spa-pal/UKU207_DOCS/src/фото/207_14/PXL_20231024_051923921.jpg

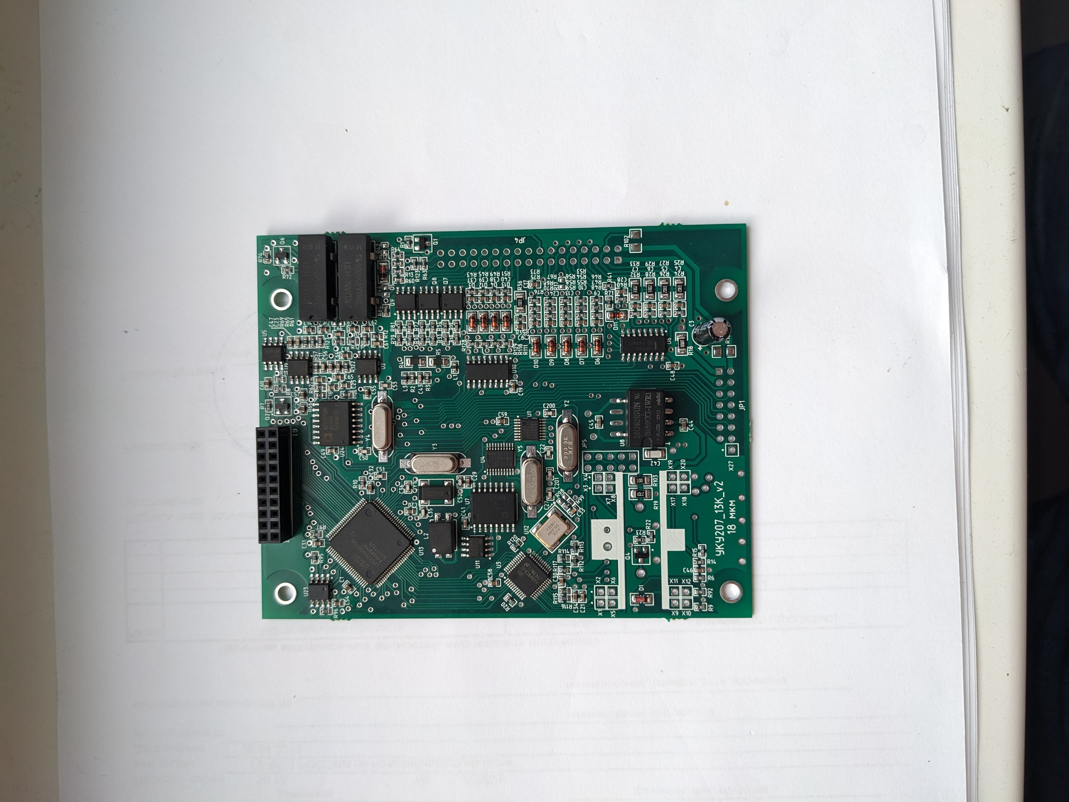
src/фото/207_14/PXL_20231024_051923921.jpg
