spa-pal/UKU207_DOCS/Названия вариантов пайки SMD.docx

Плата контроллера

| Ethernet | Измеритель токов батарей | ФЗ | Применение
УКУ207_13К_v2_SMD1 (УКУ207.14) | + | + | - | 14.48
УКУ207_13К_v2_SMD2 (УКУ207.12/13) | + | - | + | 11.70, 11.220, 12.48, 12.220, 13.70, 13.220,
УКУ207_13К_v2_SMD3 | - | + | - | 16, 16R

Плата источника питания

| Uin | LBH10 | RS485 | Применение
УКУ20713_power_SMD1 | 220 | + | 1 | 11.220,
УКУ20713_power_SMD2 | 220 | + | 2 | 13.220,
УКУ20713_power_SMD3 | 48 | - | 1 | 14.48, 12.48
УКУ207_13К_v2_SMD3 | - | + | - | 16, 16R
