spa-pal/UKU207_DOCS/УКУ207.11.24-70.docx

Инструкция по сборке УКУ207.11.24-70

Исходные материалы:

Плата индикации - УКУ207_14И_SMD

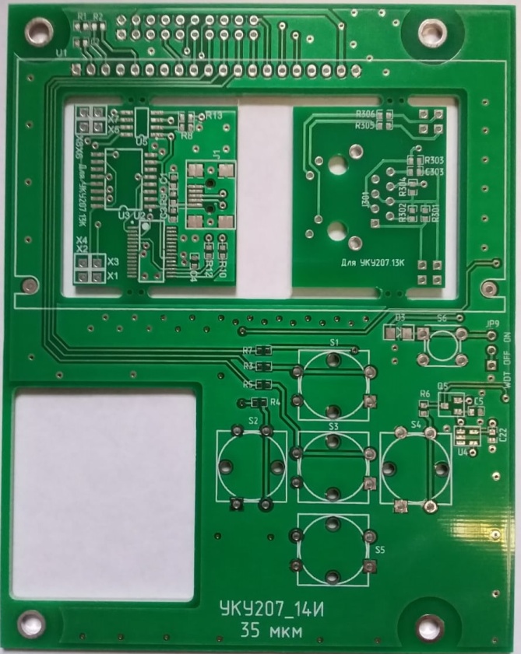
[picture p3: figure]

Плата контроллера - УКУ207_13К_v2_SMD2

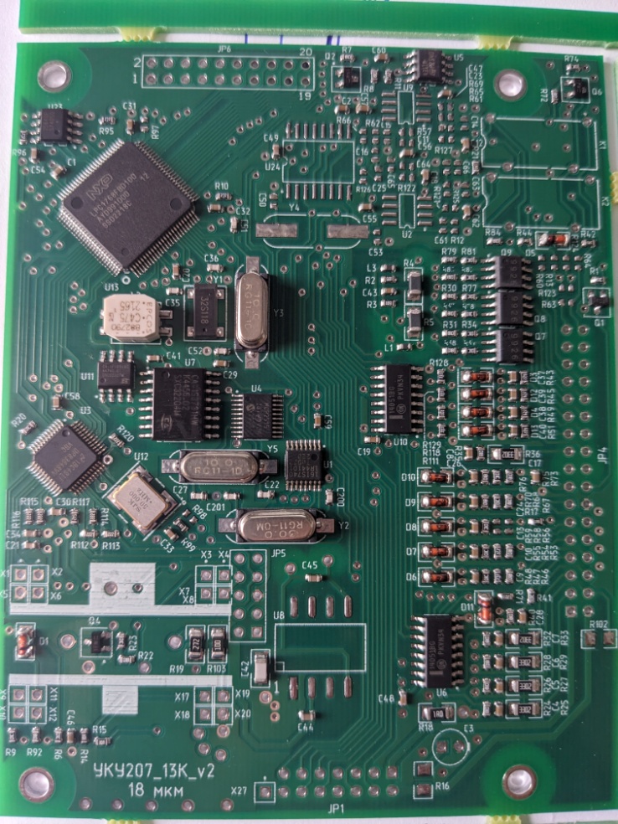
[picture p4: figure]

Плата источника питания - УКУ20713_power_SMD1

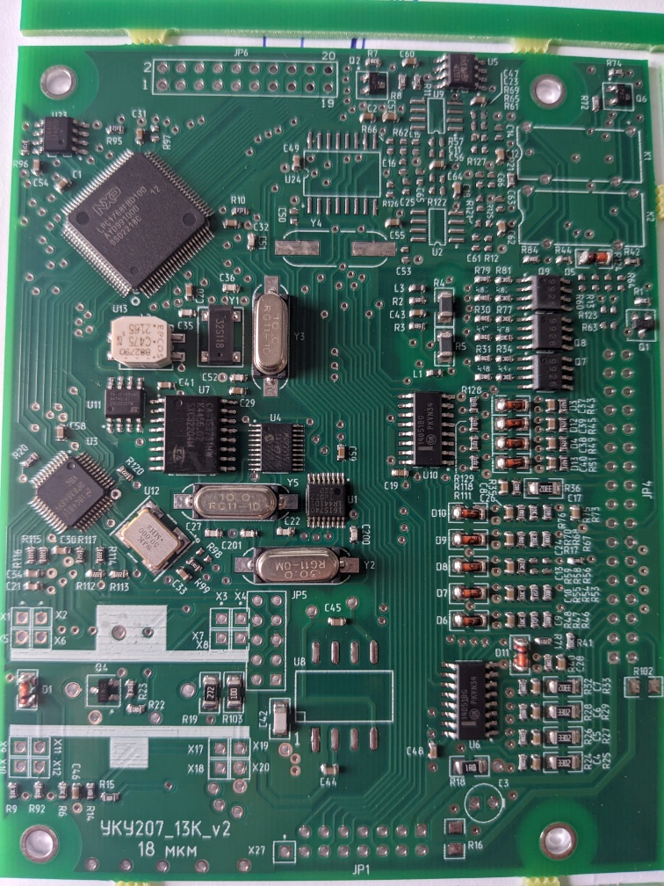
[picture p5: figure]

Плата переходник 34-14

Список элементов на допайку – УКУ207.11.24-70 список выводных элементов
