spa-pal/UKU207_DOCS/src/фото/207_12/PXL_20231101_090011275.jpg

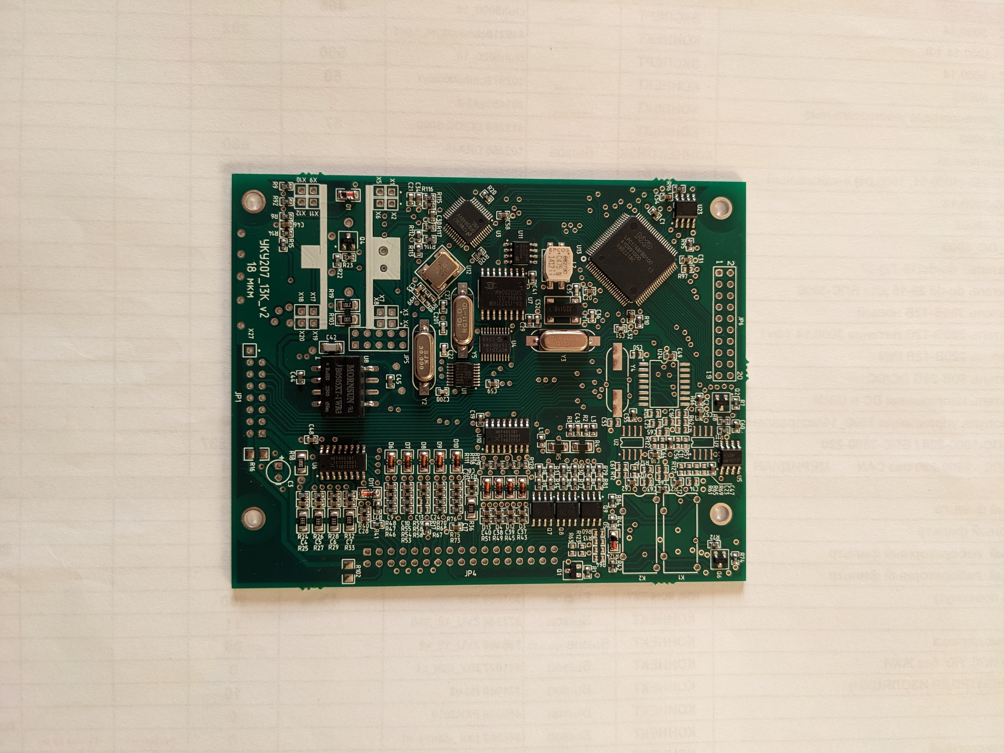
src/фото/207_12/PXL_20231101_090011275.jpg
