spa-pal/UKU207_DOCS/src/фото/207_12/PXL_20231101_101607342.PORTRAIT.ORIGINAL.jpg

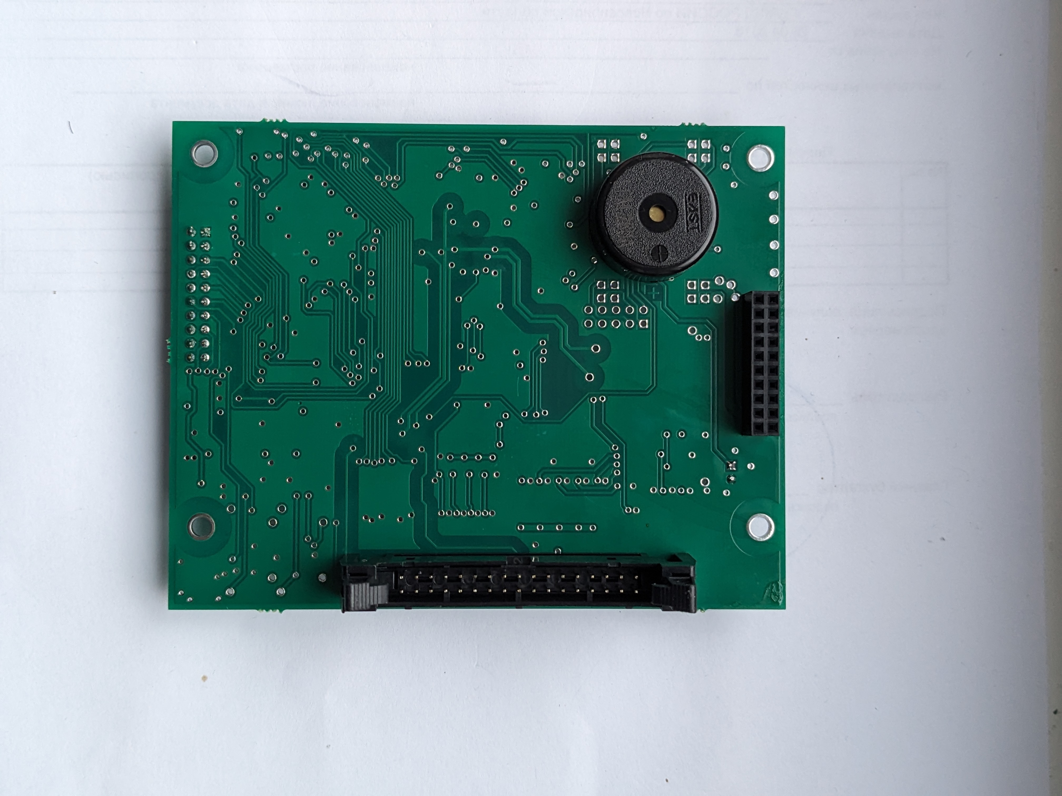
src/фото/207_12/PXL_20231101_101607342.PORTRAIT.ORIGINAL.jpg
