spa-pal/UKU207_DOCS/src/фото/207_14/PXL_20231024_045429906.jpg

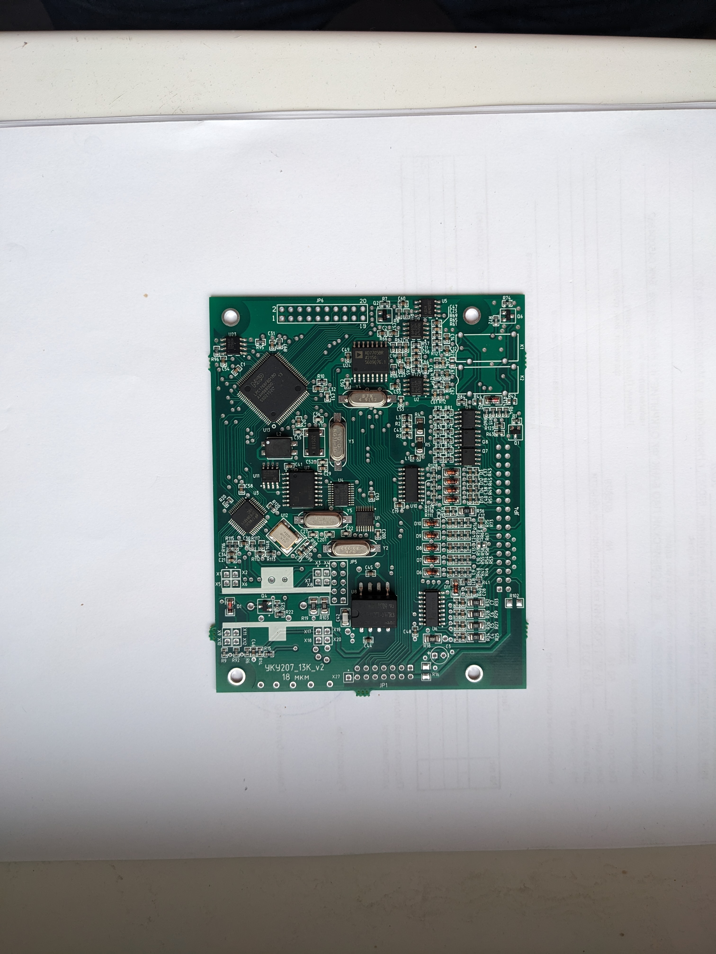
src/фото/207_14/PXL_20231024_045429906.jpg
