spa-pal/UKU207_DOCS/src/фото/207_14/PXL_20231024_105109029.jpg

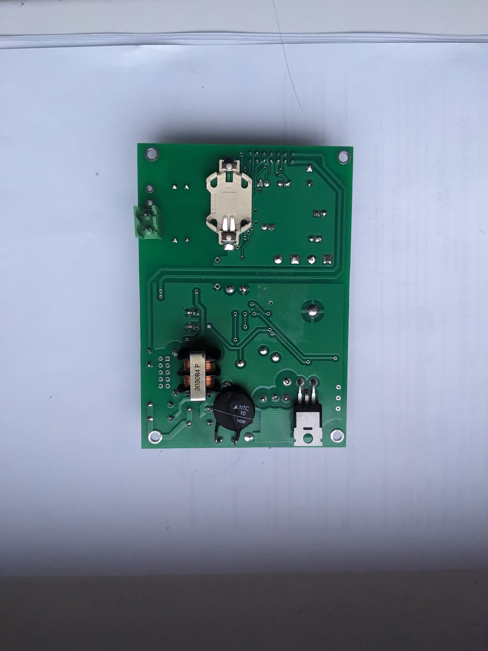
src/фото/207_14/PXL_20231024_105109029.jpg
