spa-pal/UKU207_DOCS/src/фото/ИП220/PXL_20231101_123538262.jpg

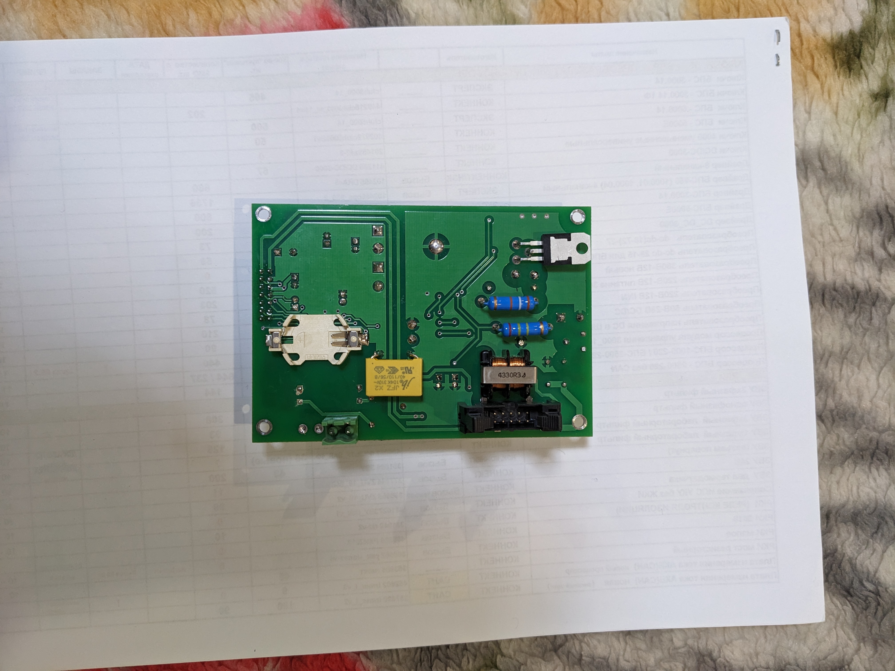
src/фото/ИП220/PXL_20231101_123538262.jpg
