spa-pal/UKU207_DOCS/src/фото/ИП220/PXL_20231101_123554550.jpg

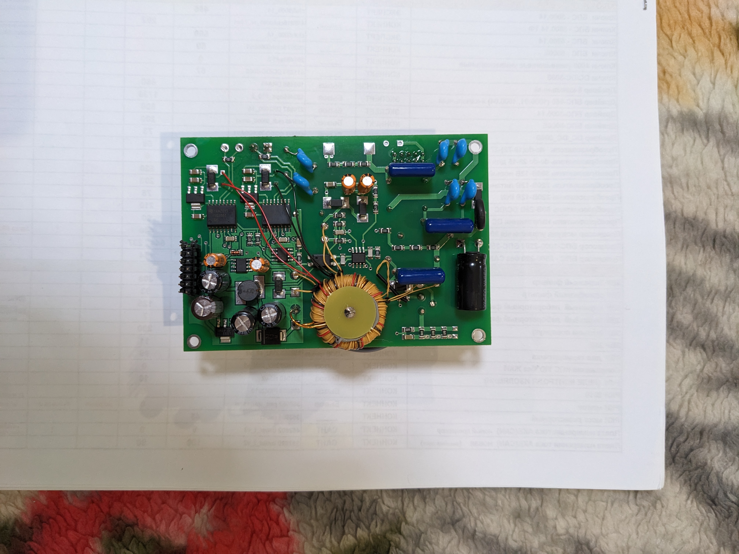
src/фото/ИП220/PXL_20231101_123554550.jpg
