spa-pal/UKU207_DOCS/src/фото/УКУ207_13И_безSMD.jpg

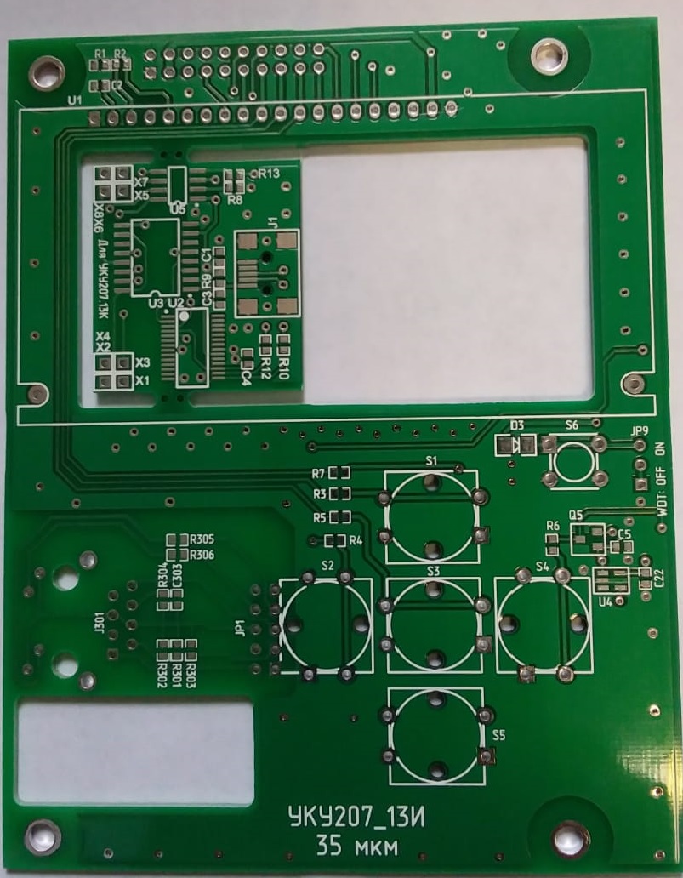
src/фото/УКУ207_13И_безSMD.jpg
