spa-pal/UKU207_DOCS/src/фото/УКУ207_13К_v2_smd1.jpg

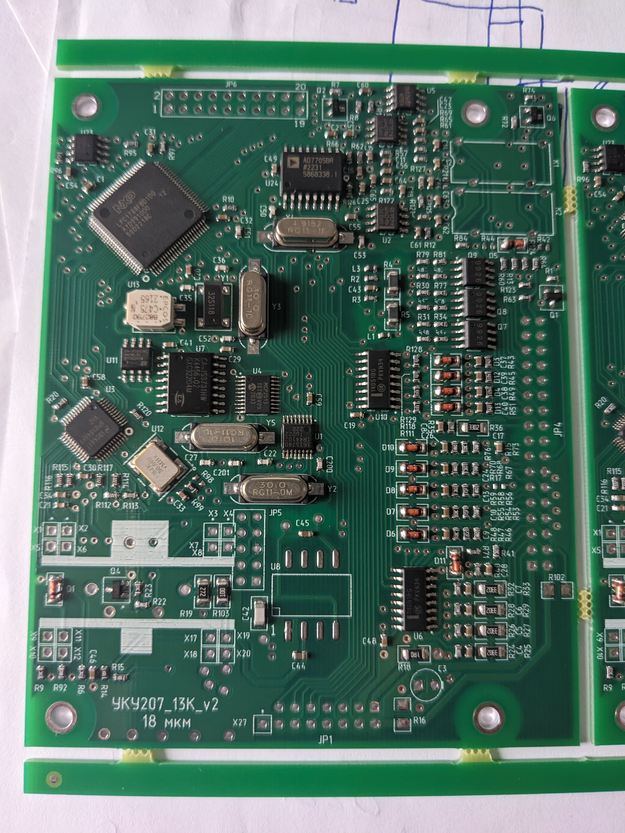
src/фото/УКУ207_13К_v2_smd1.jpg
