spa-pal/UKU207_DOCS/src/фото/УКУ207_16И.jpg

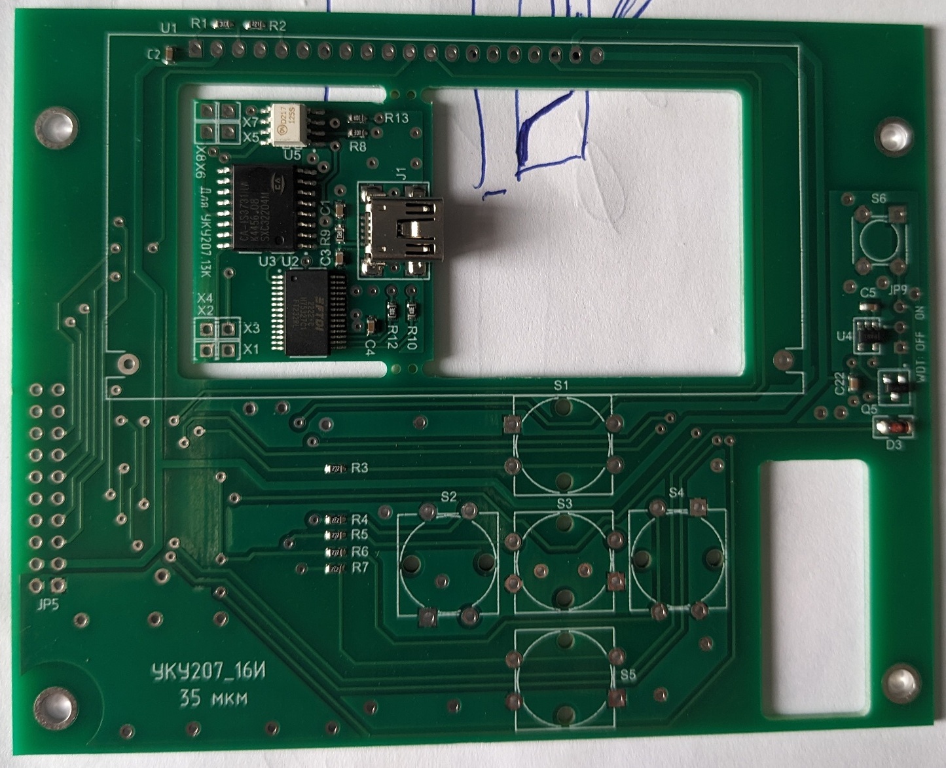
src/фото/УКУ207_16И.jpg
