spa-pal/UKU207_DOCS/3d/uku207_1.stl

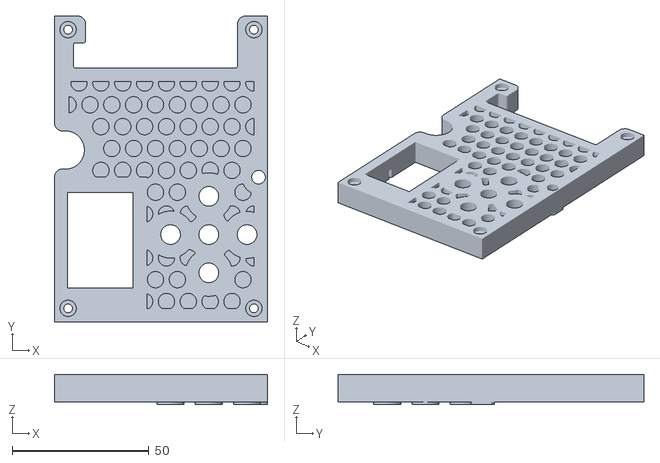
[picture p25: CAD file, 2023-10-18]
3d/uku207_1.stl
78.0 x 112.0 x 11.0
