spa-pal/UKU207_DOCS/УКУ207.12.220/УКУ207.12.220 Плата контроллера монтажка.pdf

1

2

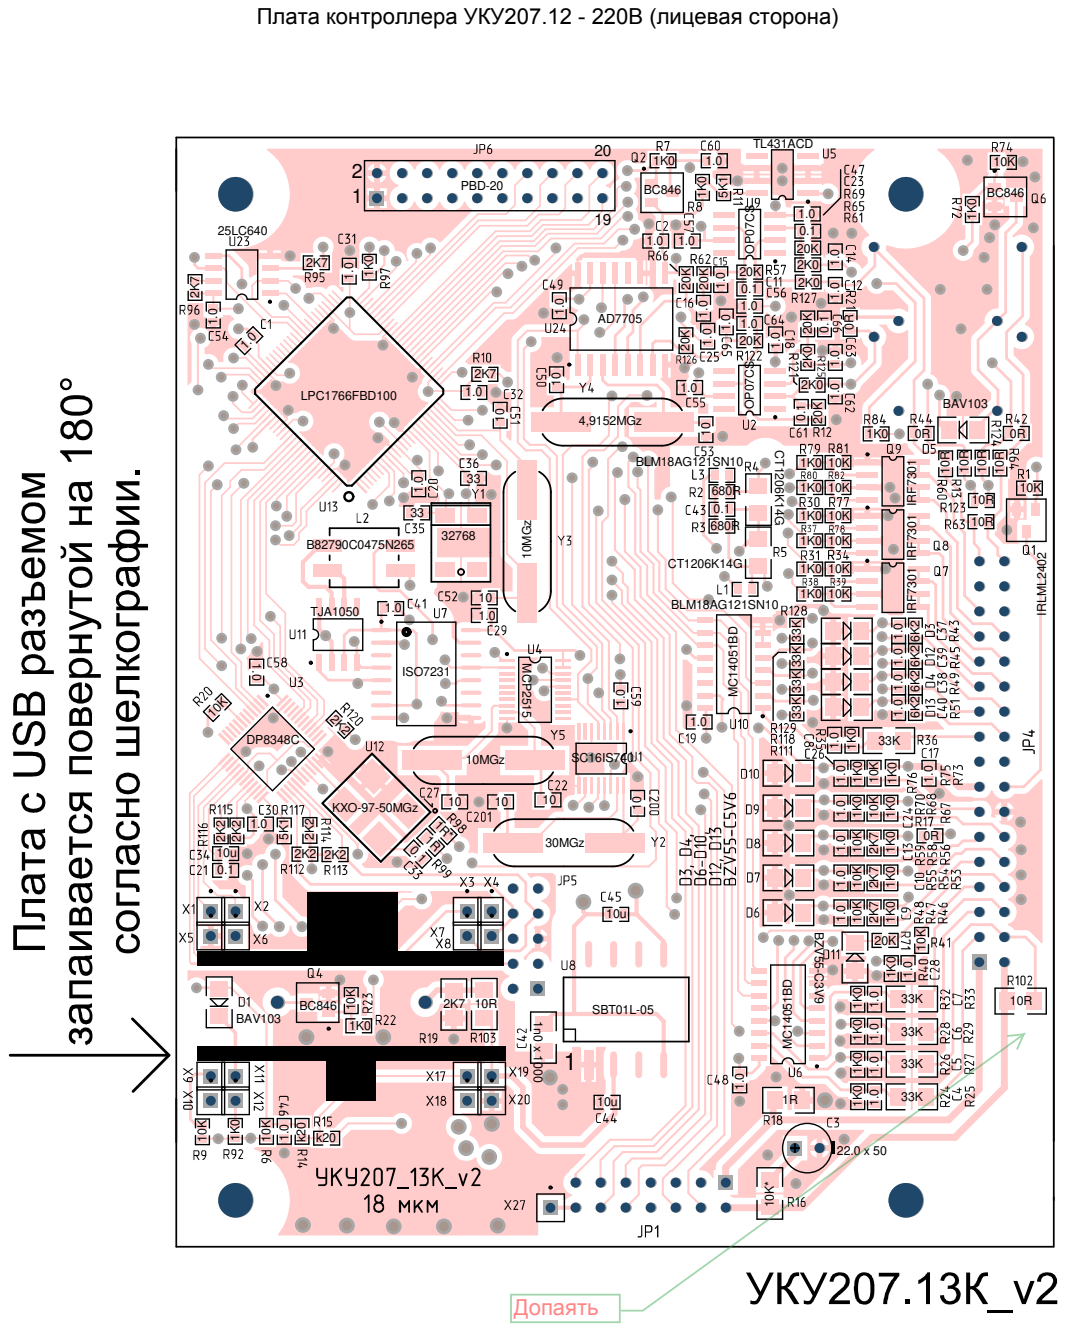
[picture p26: page 1]
10MGz; 1.0 IRF7301 IRF7301; MCP2515; IRF7301; TJA1050; ISO7231; BAV103; 33K ¹⁰K; 10R¹⁰R; BZV55-C3V9; IRLML2402; KXO-97-50MGz; PBD-20; SBT01L-05; BLM18AG121SN10; TL431ACD; LPC1766FBD100; 30MGz; 4,9152MGz

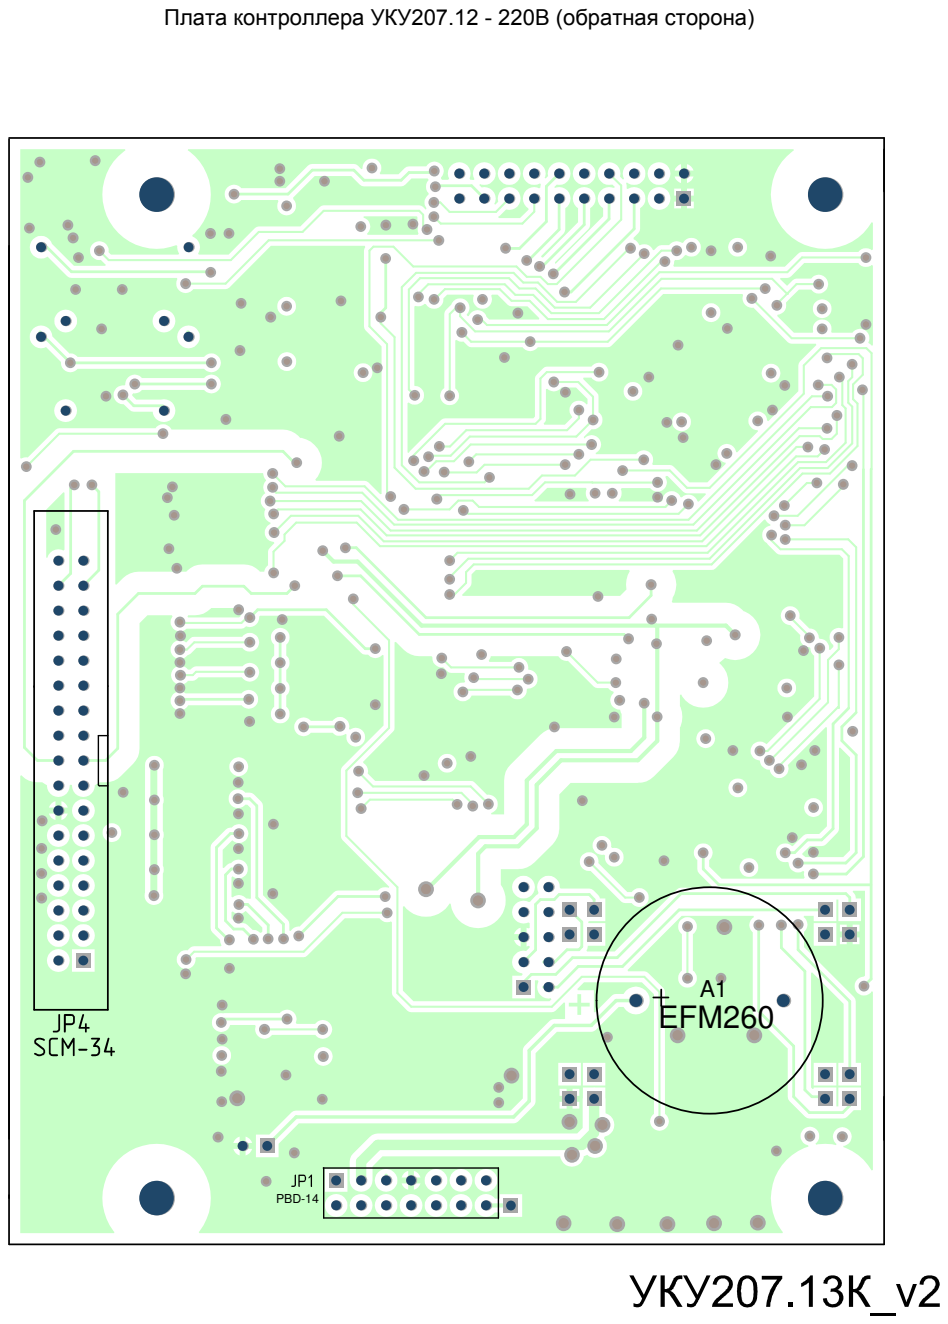
[picture p27: page 2]
PBD-14; A1 EFM260
