spa-pal/UKU207_DOCS/УКУ207.12.220/УКУ207.12.220 Плата питания монтажка.pdf

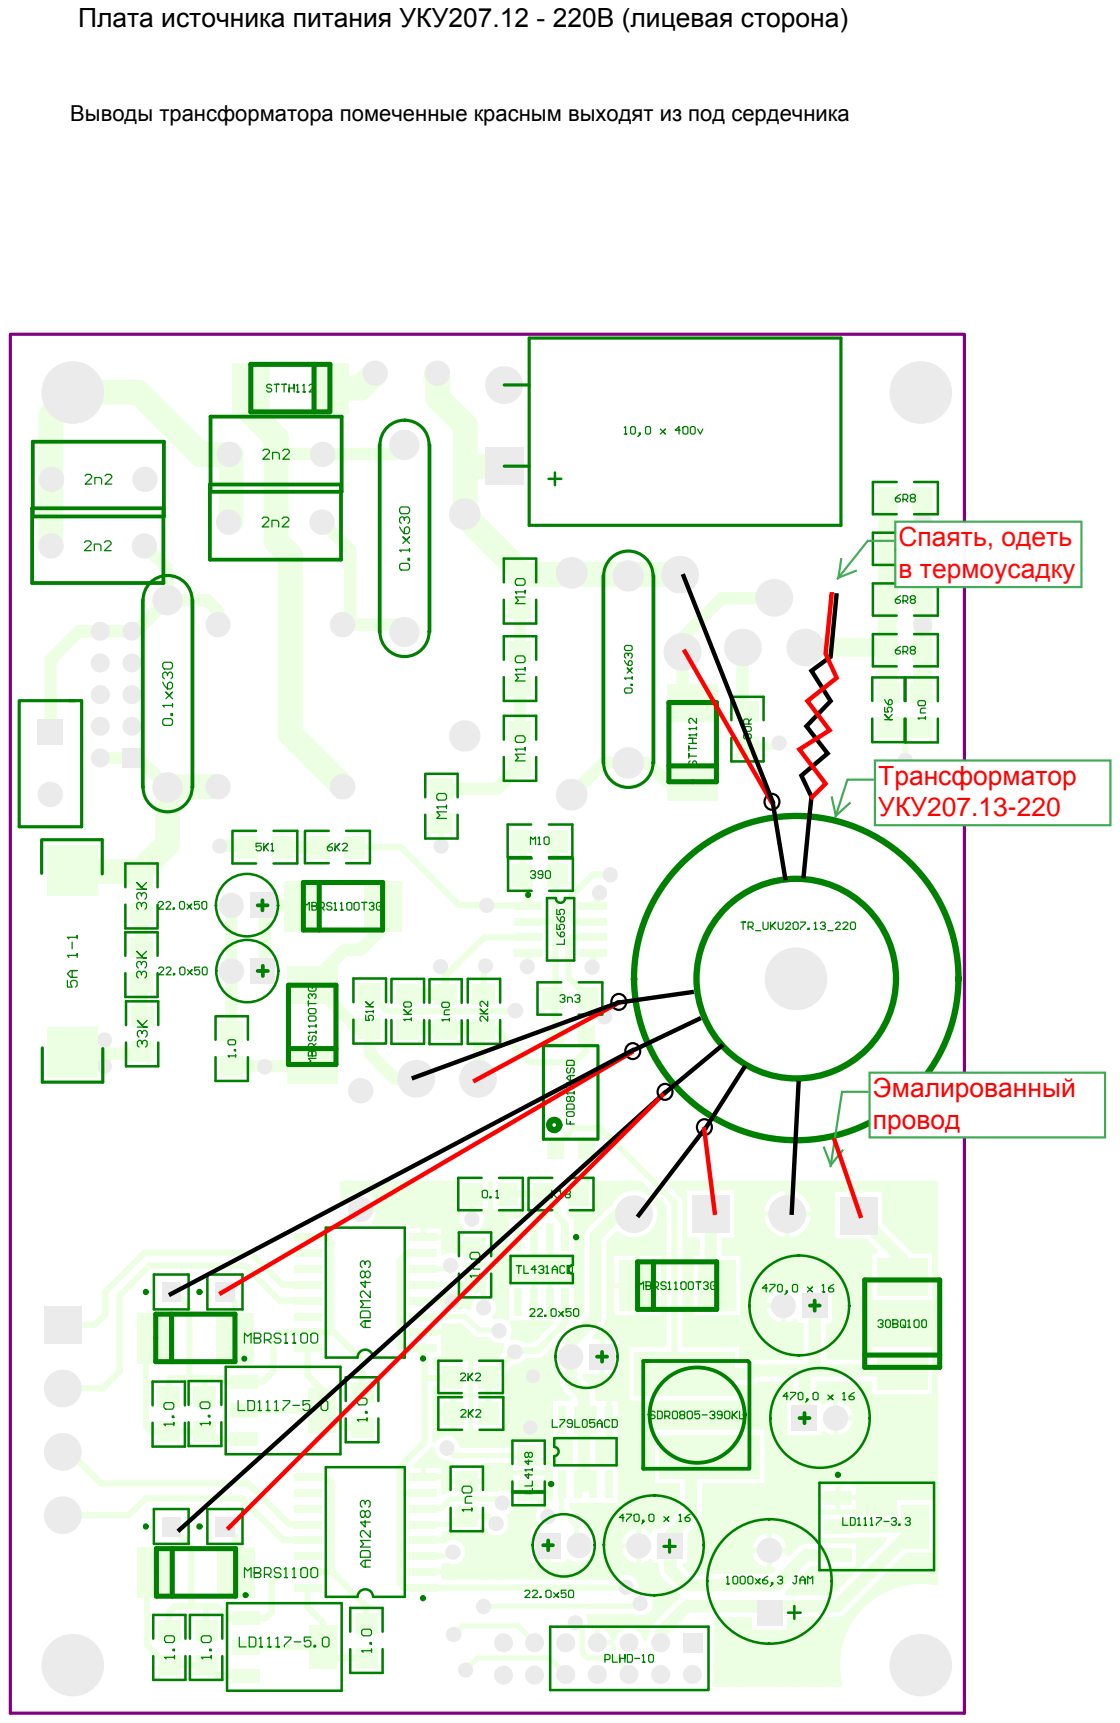
[picture p28: page 1]

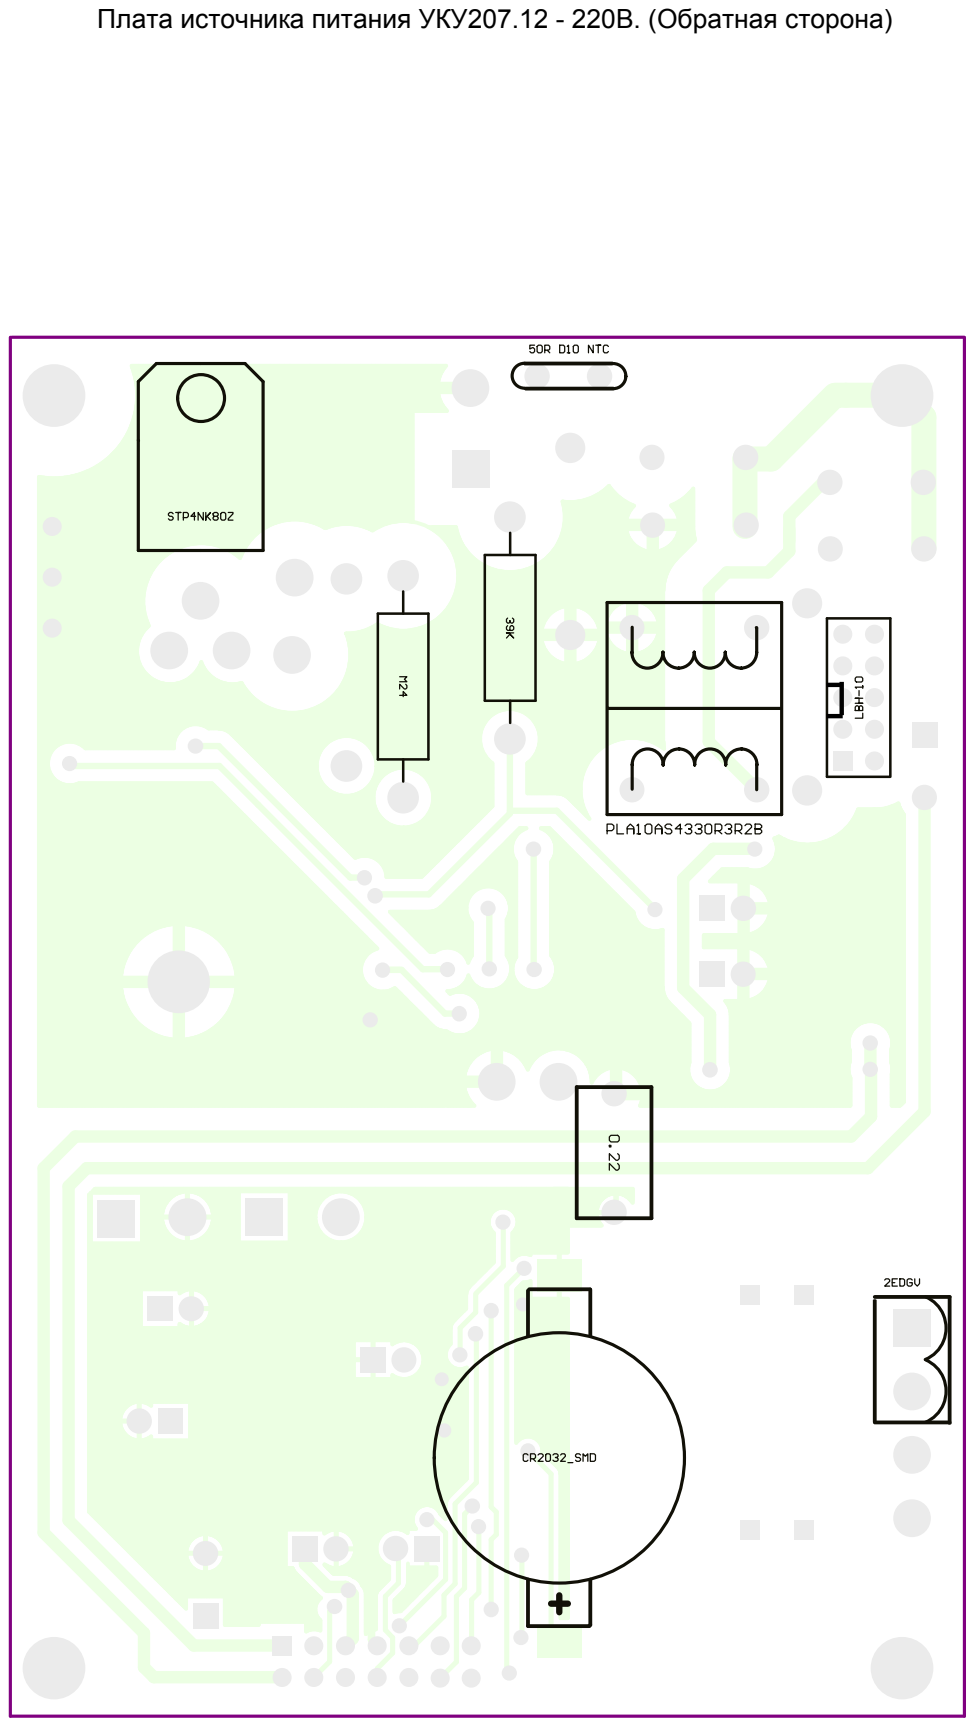
[picture p29: page 2]
