spa-pal/UKU207_DOCS/УКУ207.14.220/УКУ207.14.220 Плата питания монтажка.pdf

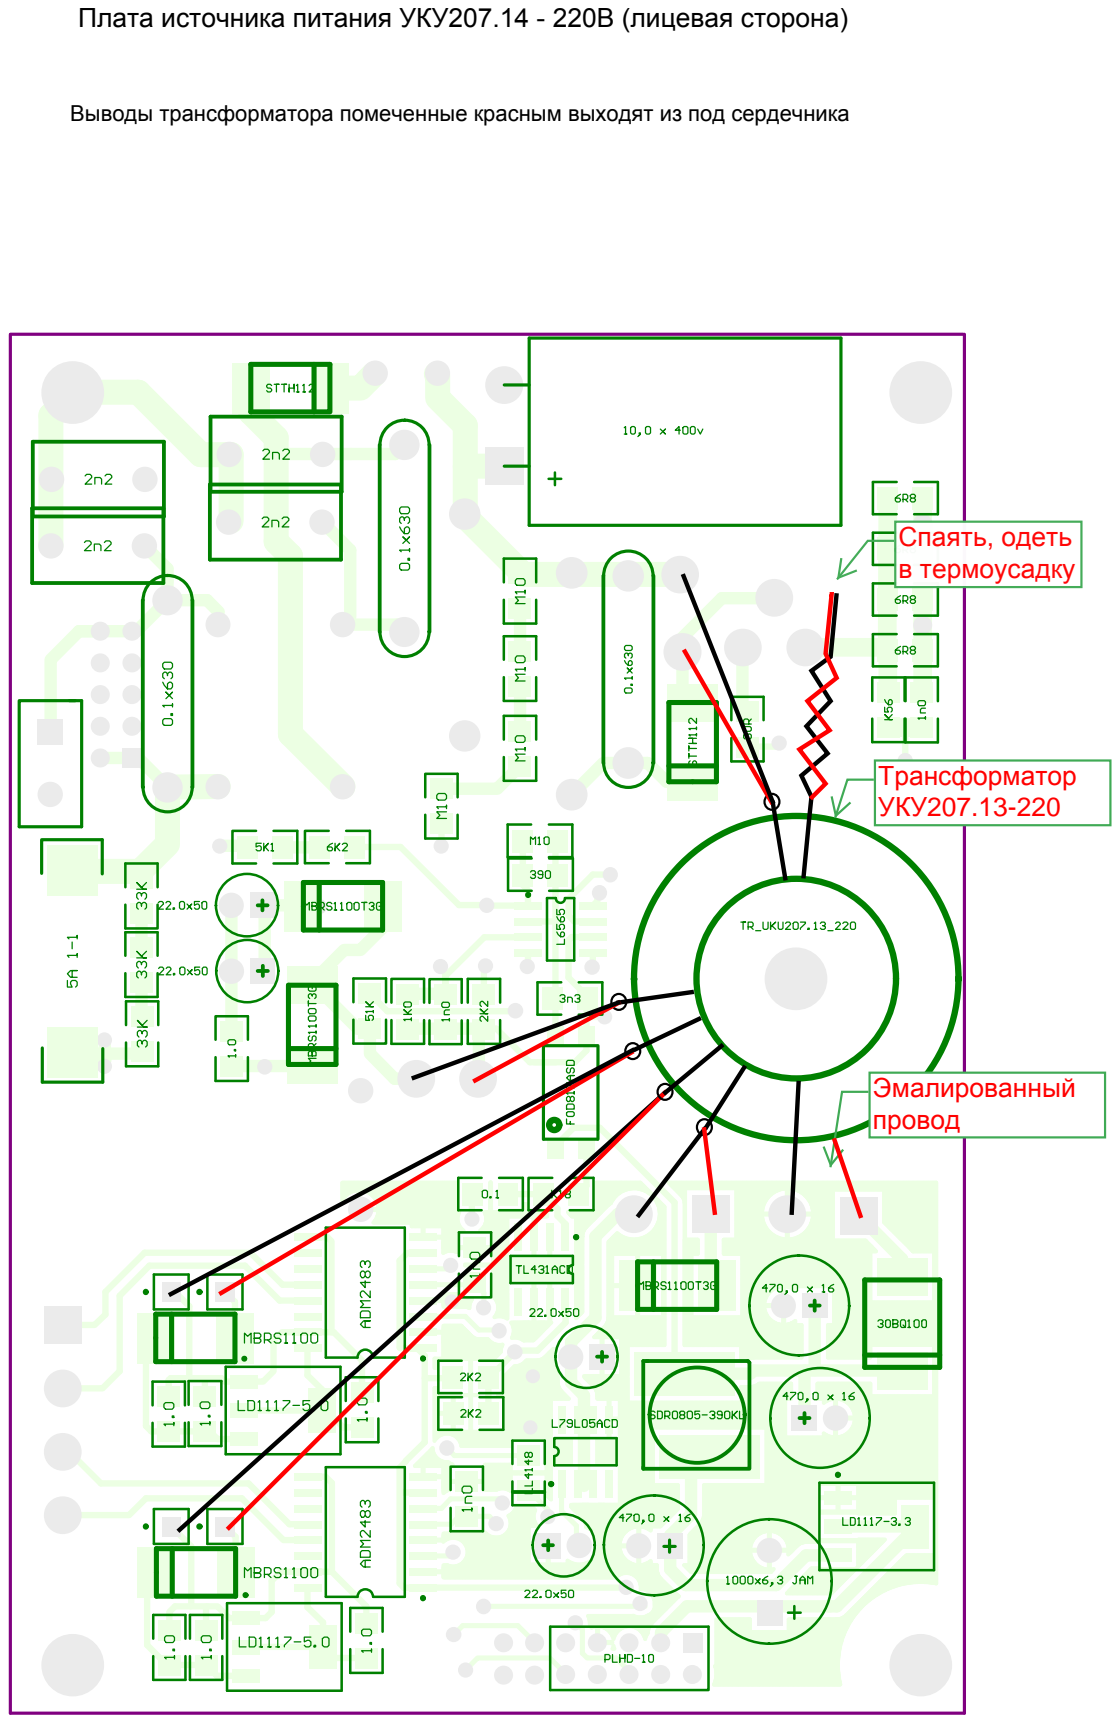
[picture p34: page 1]

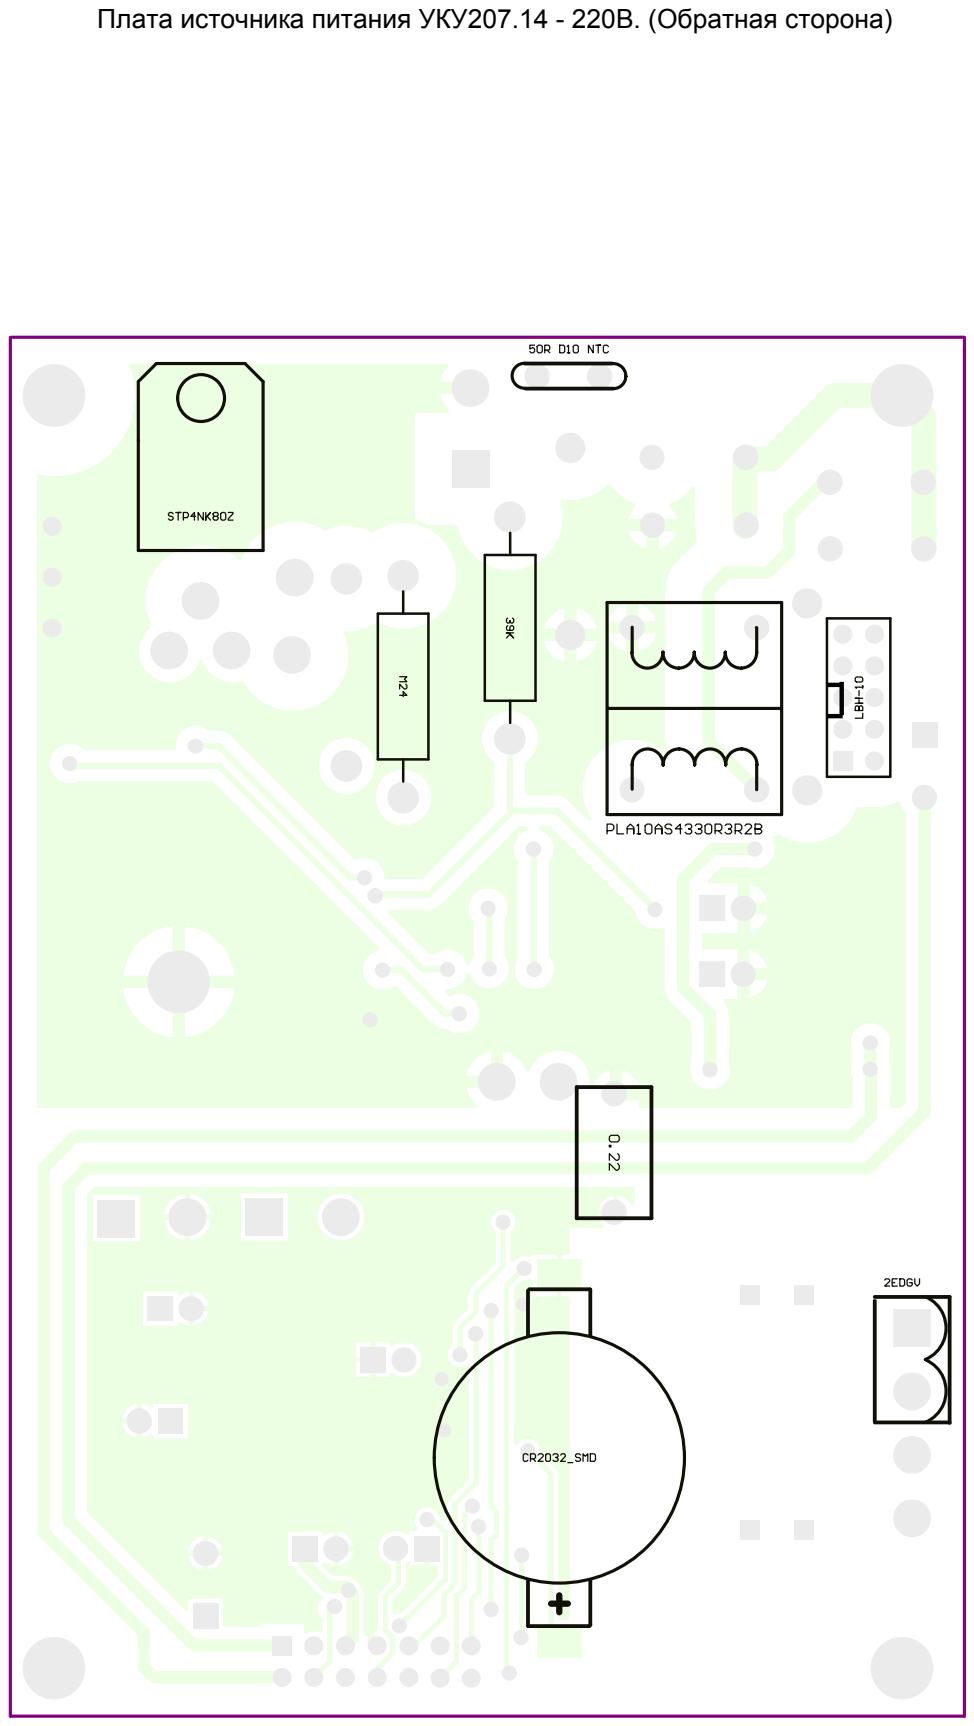
[picture p35: page 2]
