spa-pal/UKU207_DOCS/УКУ207.12.48/УКУ207.12.48 Плата питания монтажка.pdf

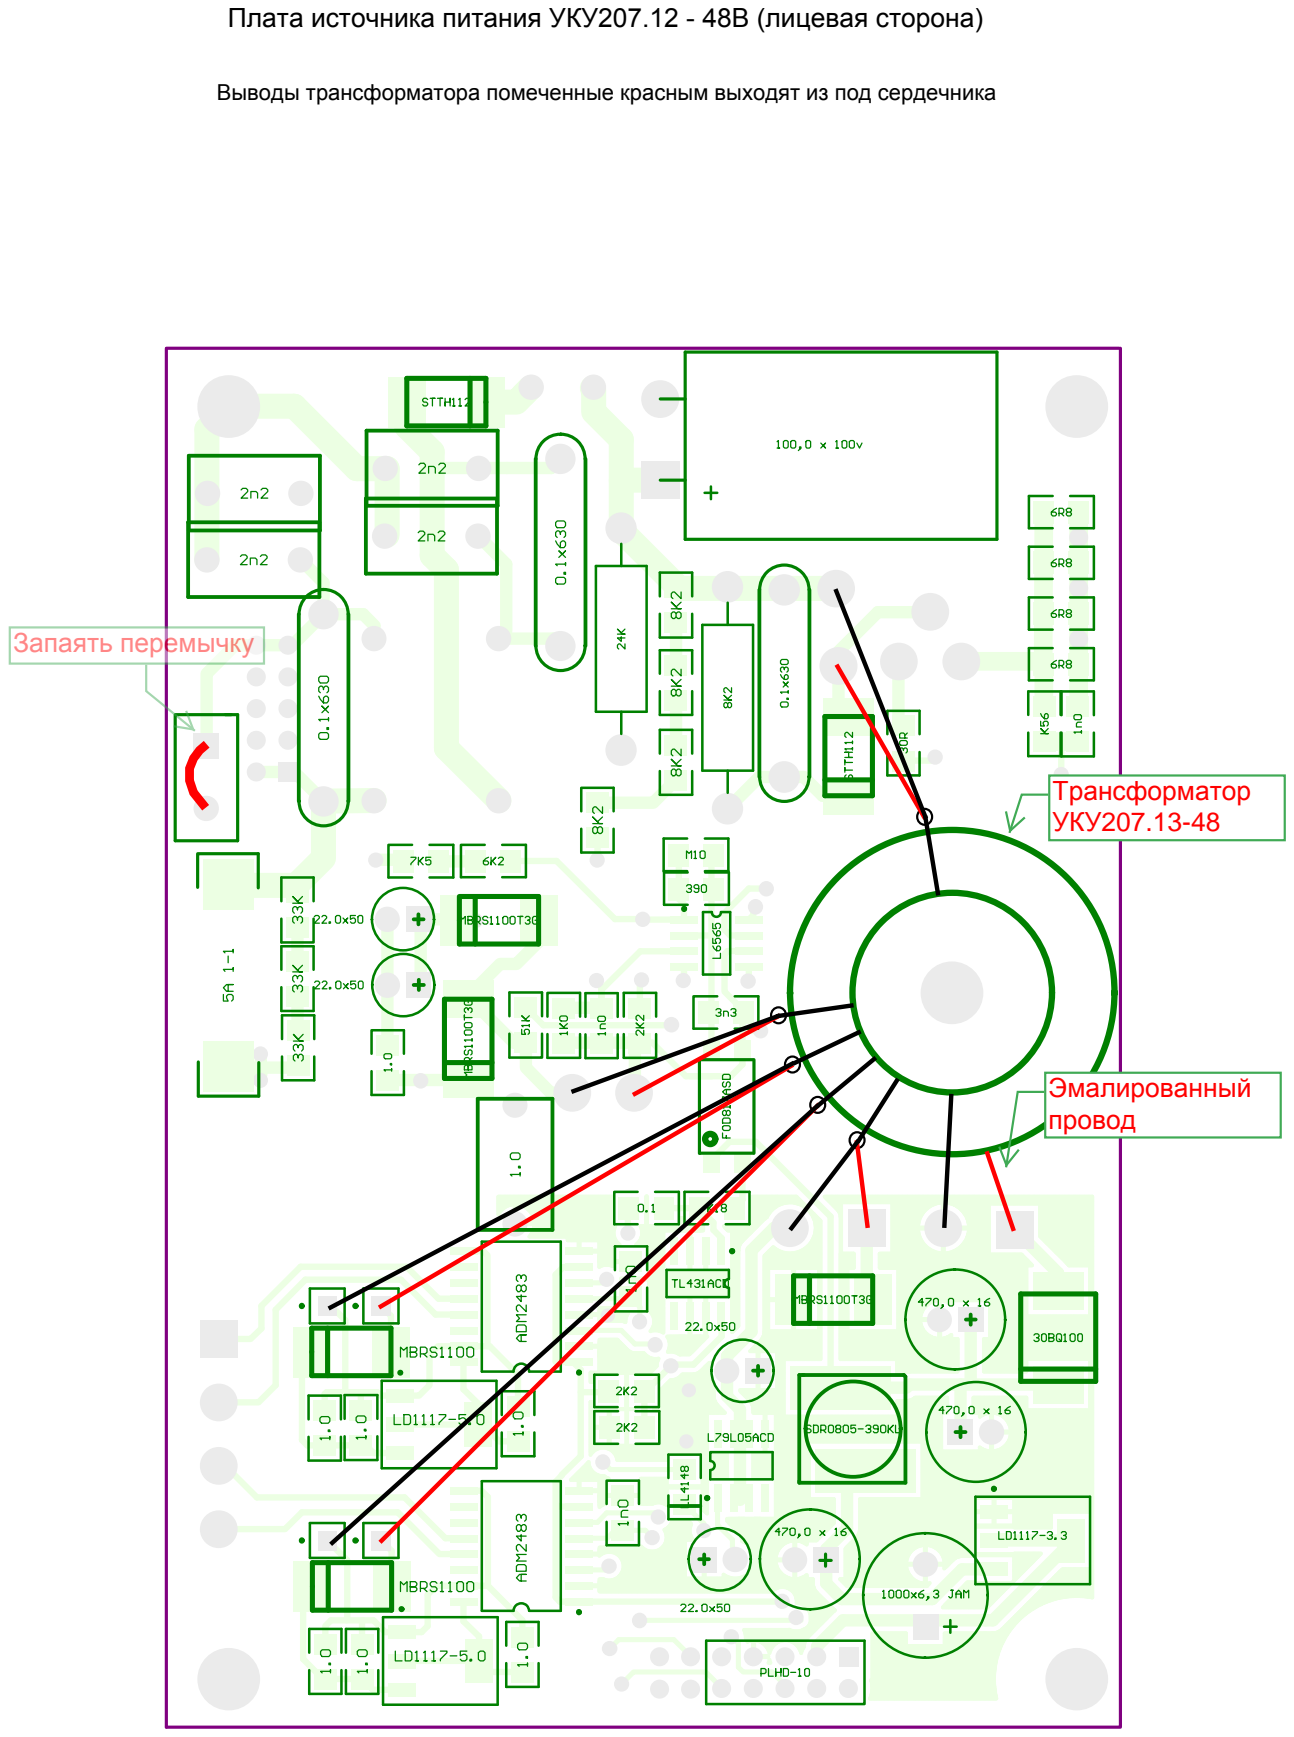
[picture p38: page 1]

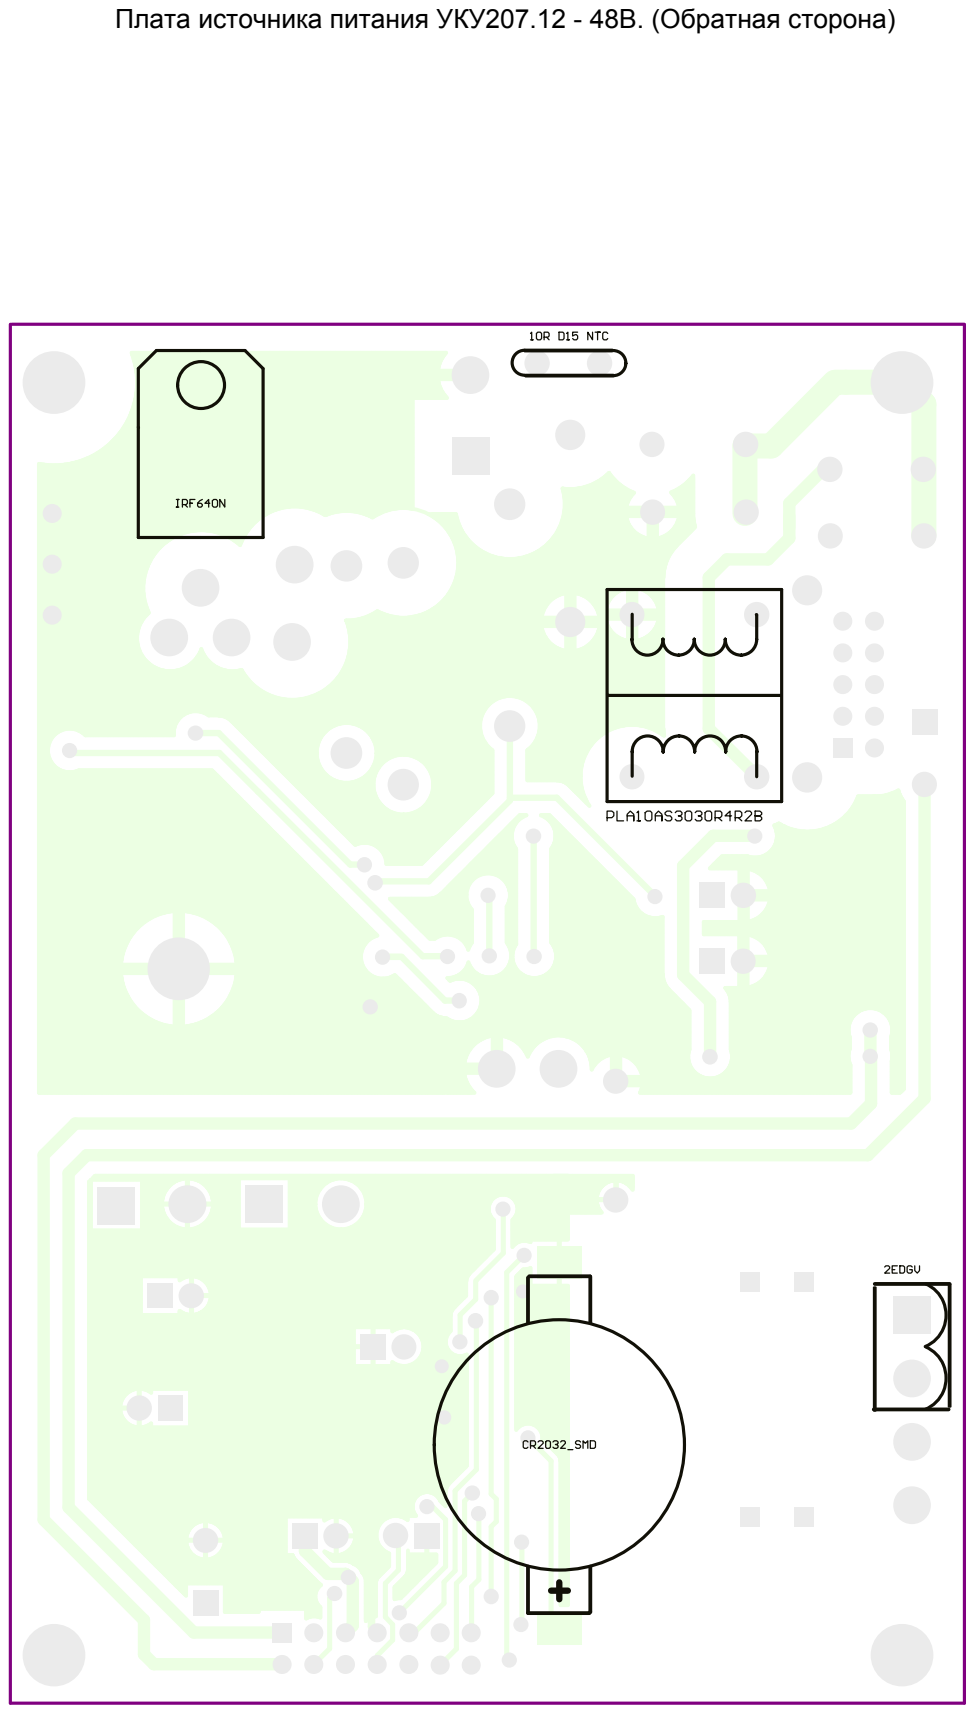
[picture p39: page 2]
