spa-pal/UKU207_DOCS/УКУ207.14.48/Монтажка источник 48.pdf

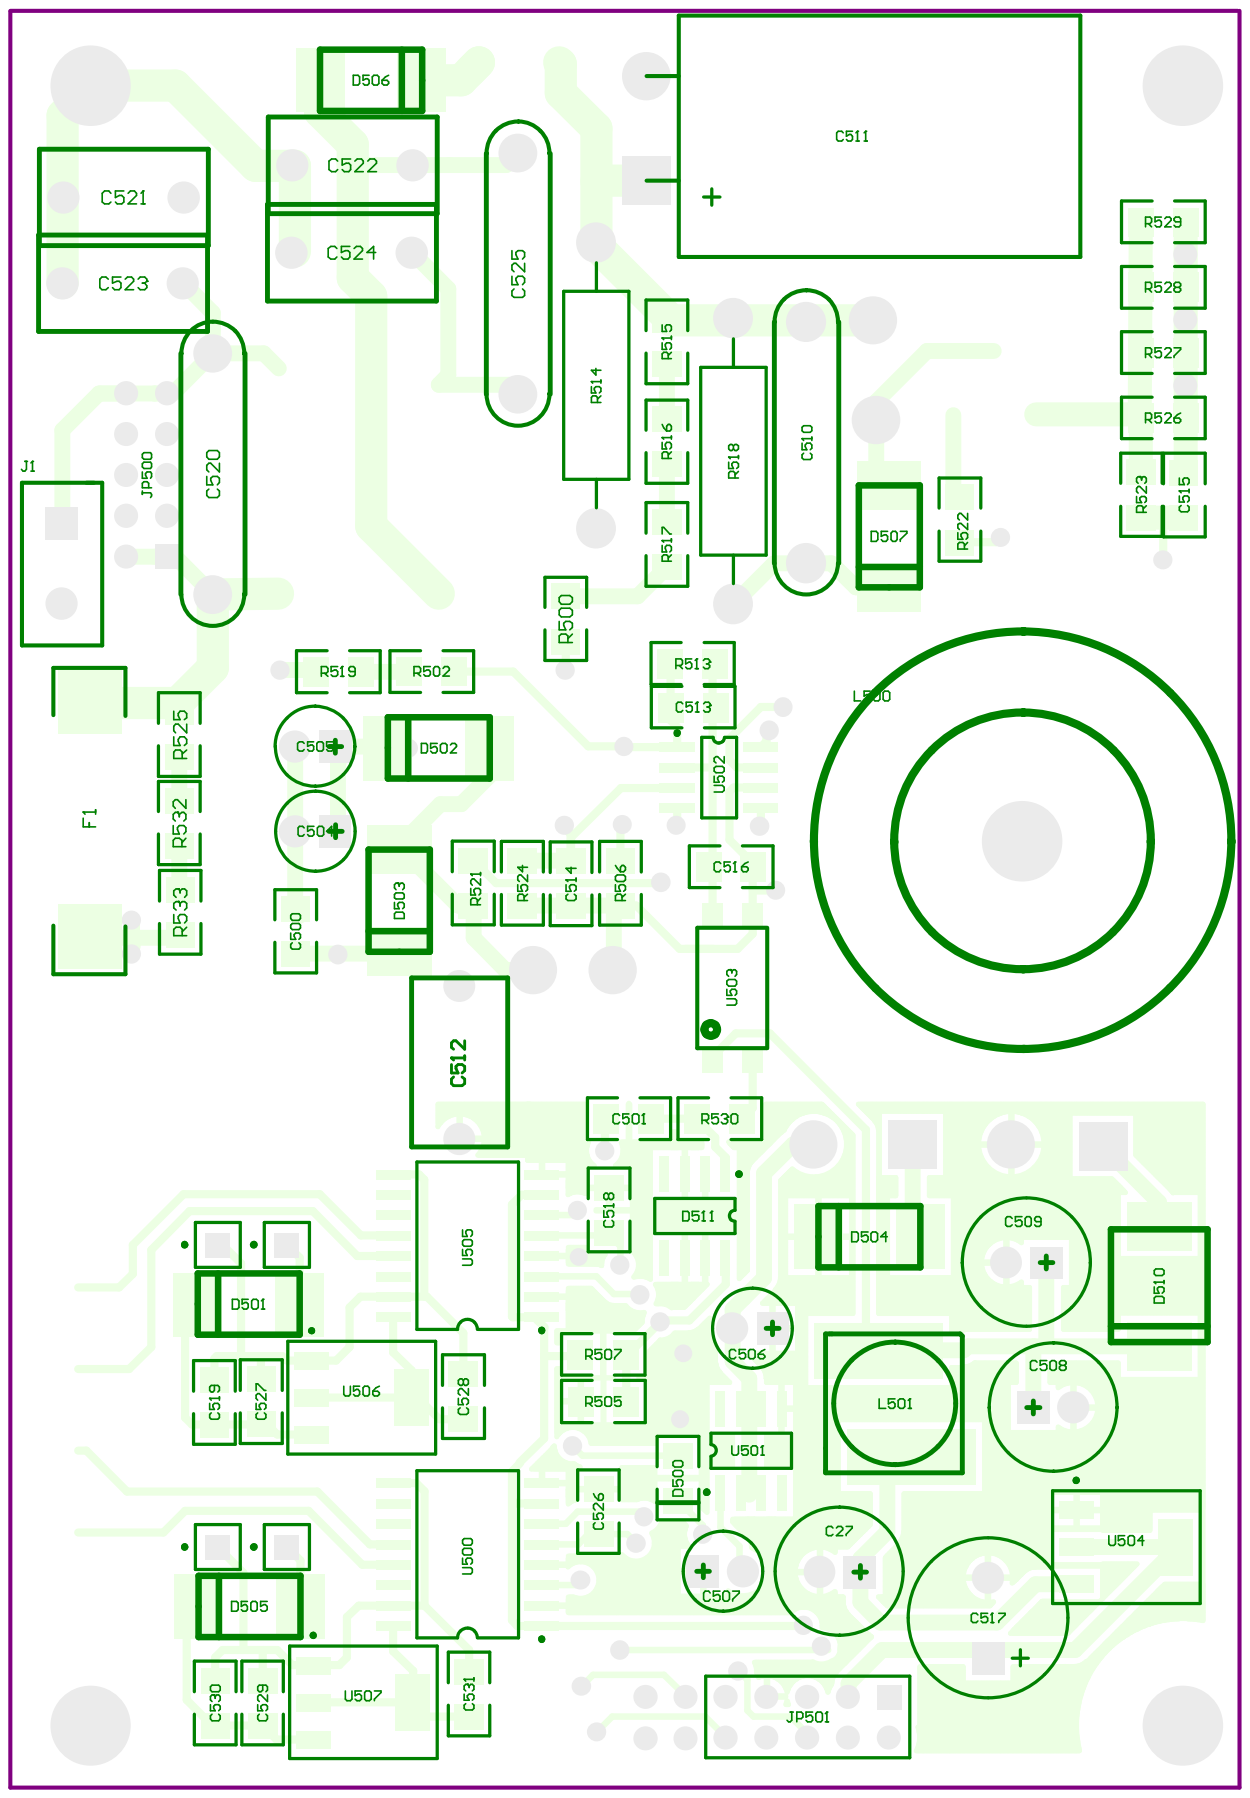
[picture p40: page 1]

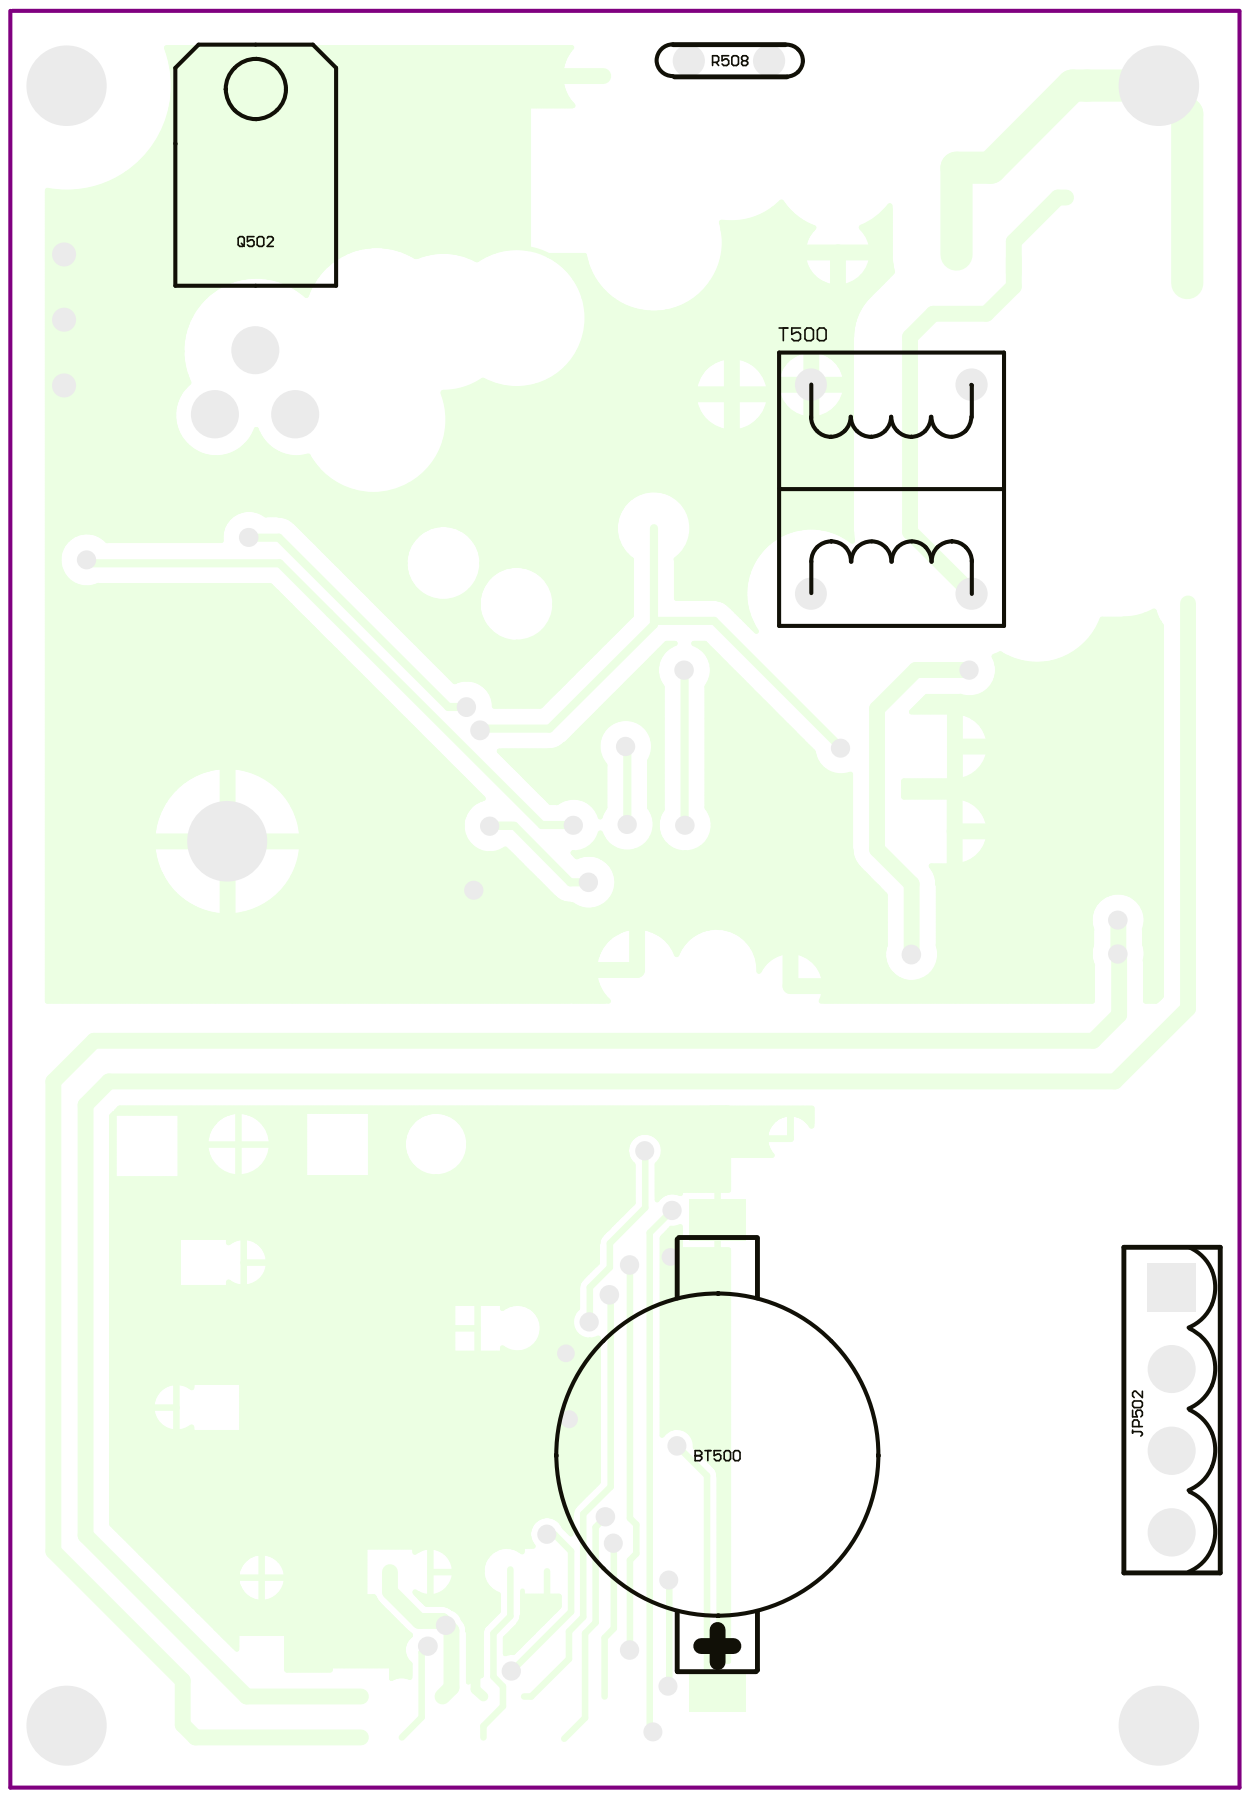
[picture p41: page 2]
