spa-pal/UKU207_DOCS/УКУ207.14.48/УКУ207.14.48 Плата питания монтажка.pdf

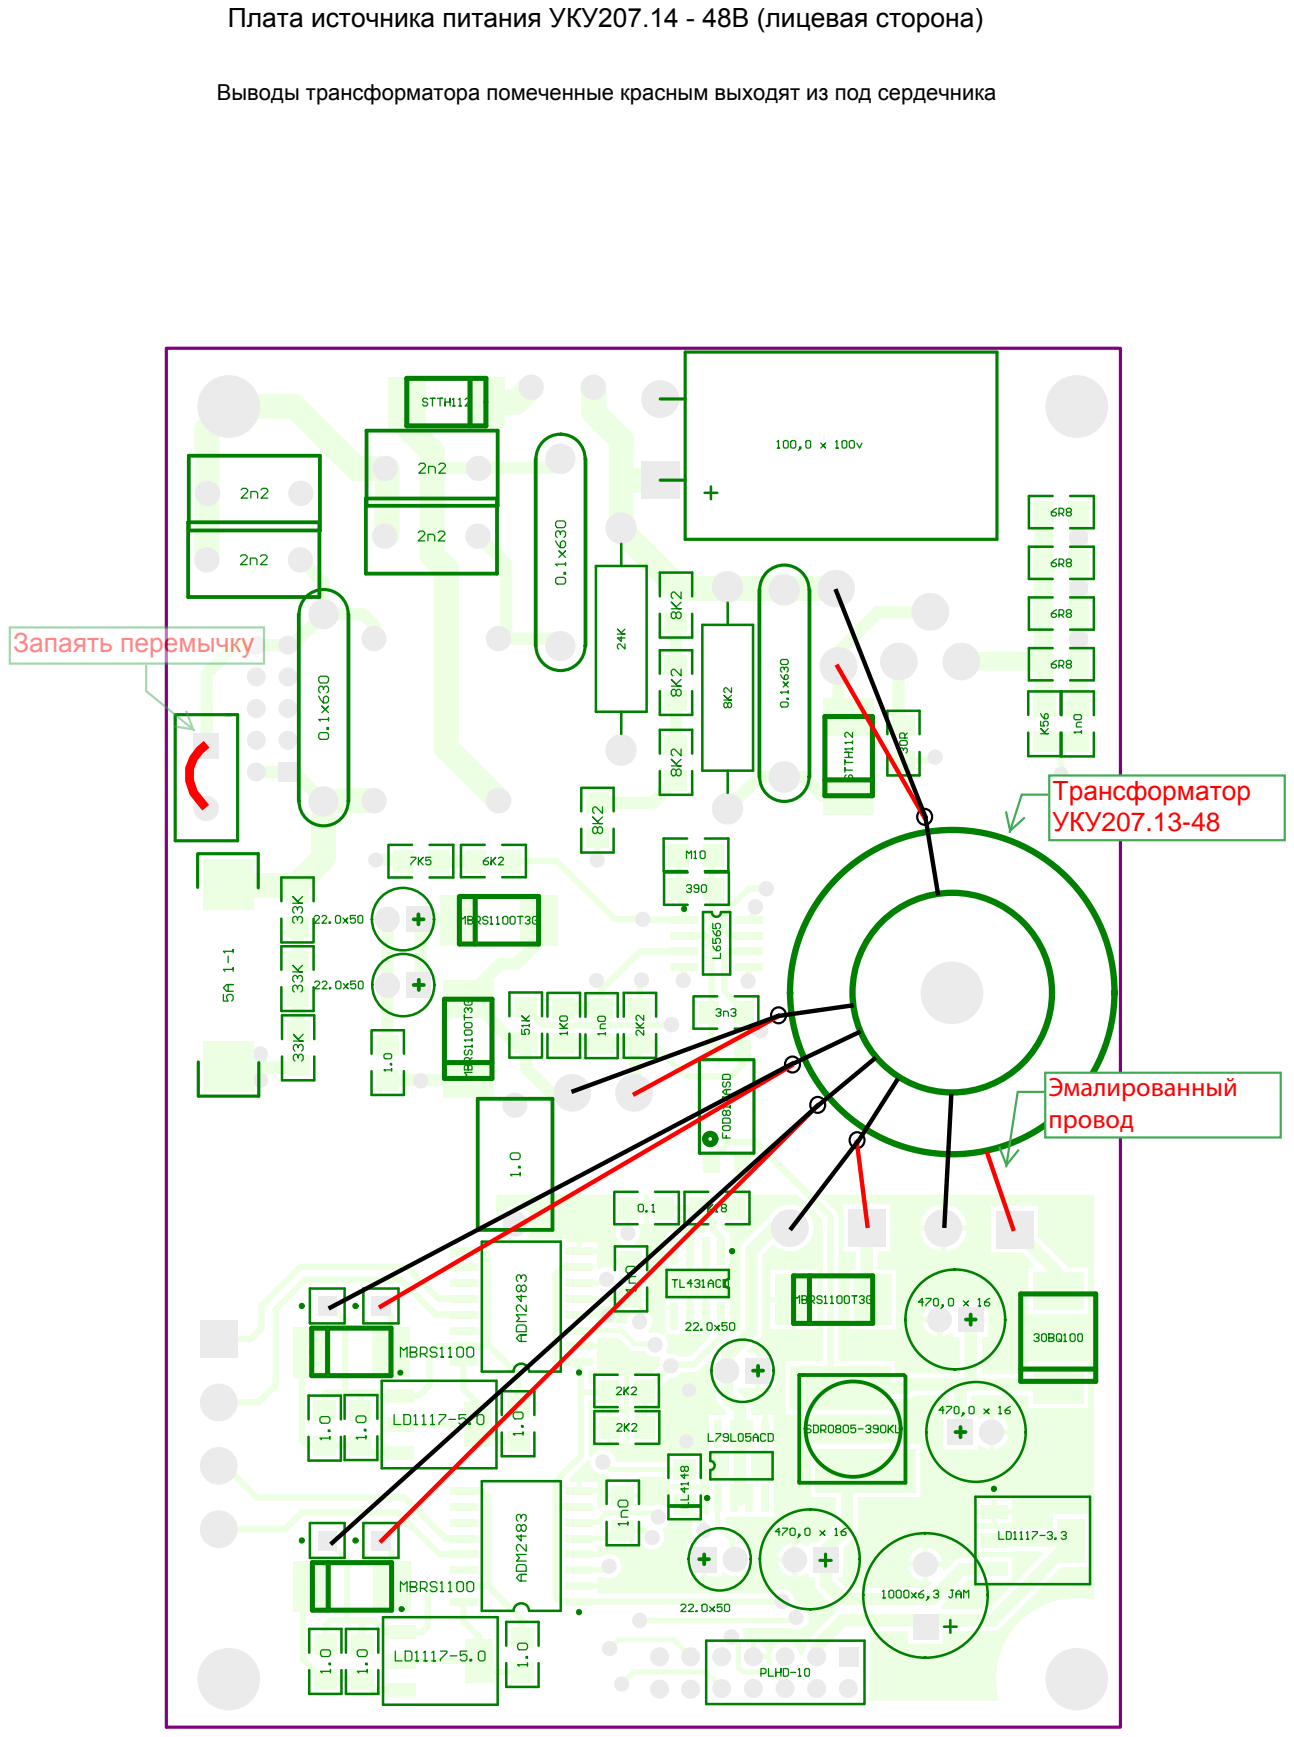
[picture p42: page 1]

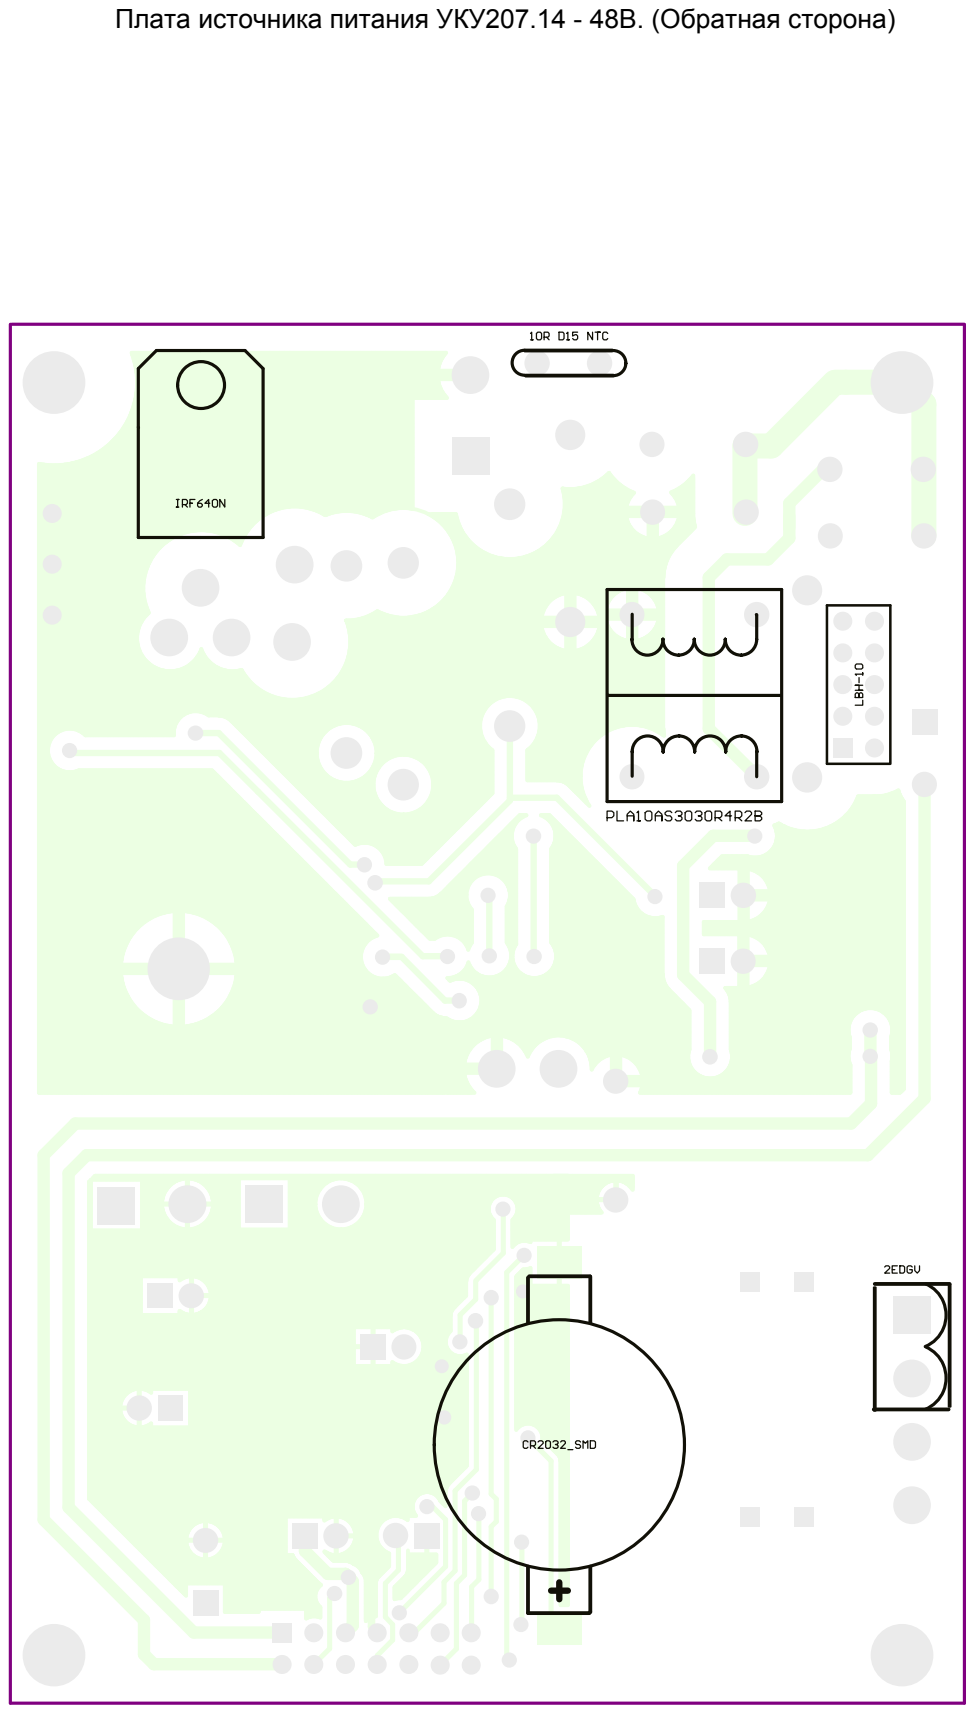
[picture p43: page 2]
