spa-pal/UKU207_DOCS/src/Схема УКУ207.13К аналоговая.pdf

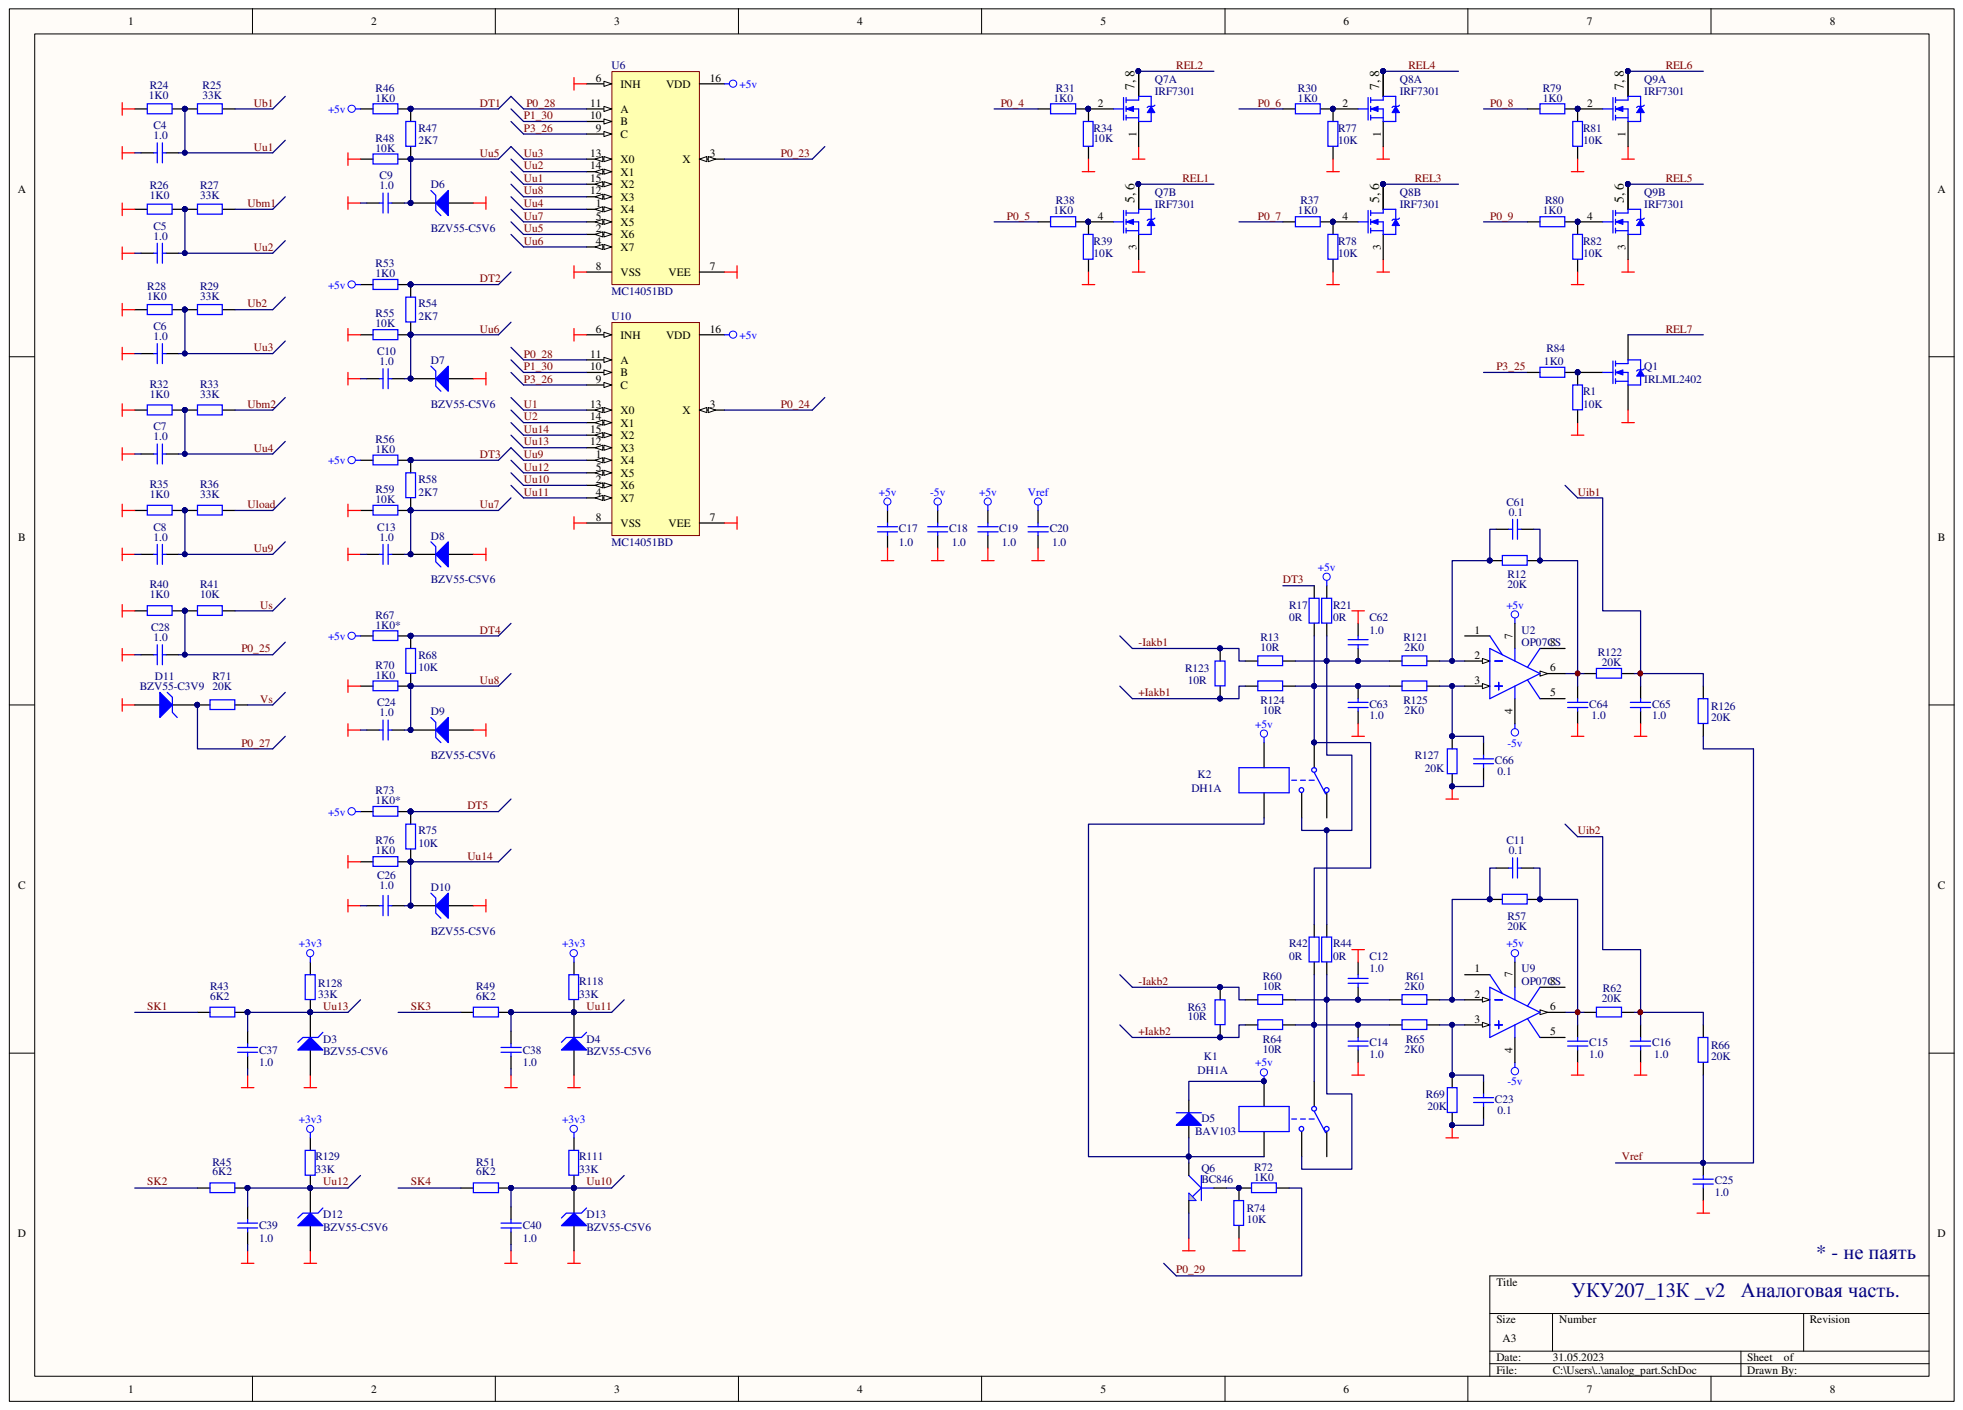
[picture p44: page 1]
