spa-pal/UKU207_DOCS/src/Схема УКУ207.13К интернет.pdf

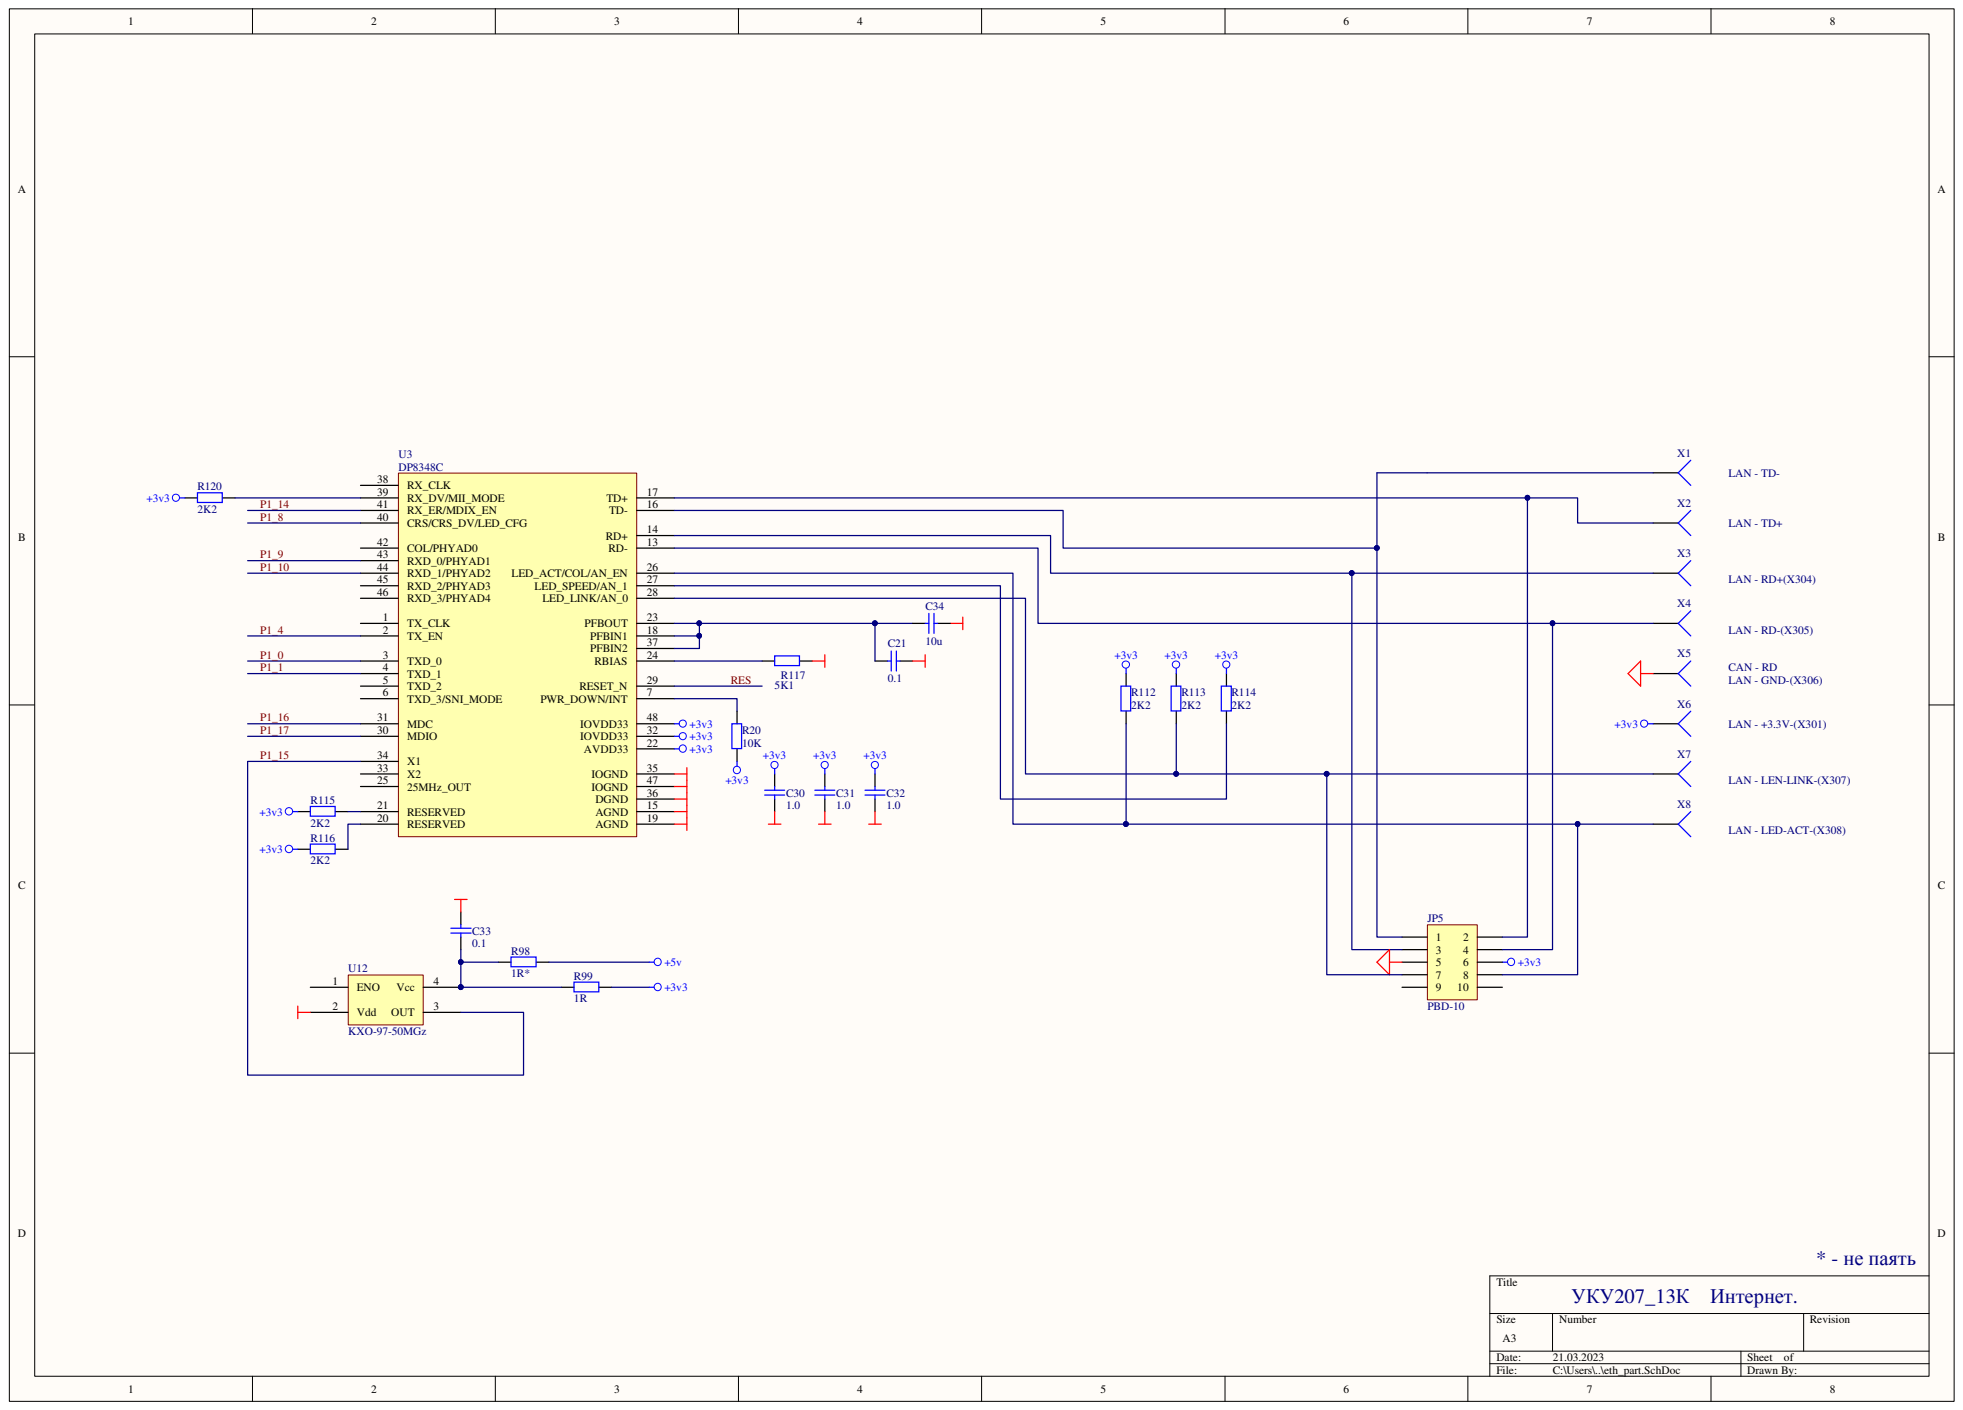
[picture p45: page 1]
