spa-pal/UKU207_DOCS/src/Схема УКУ207.13К ЦПУ.pdf

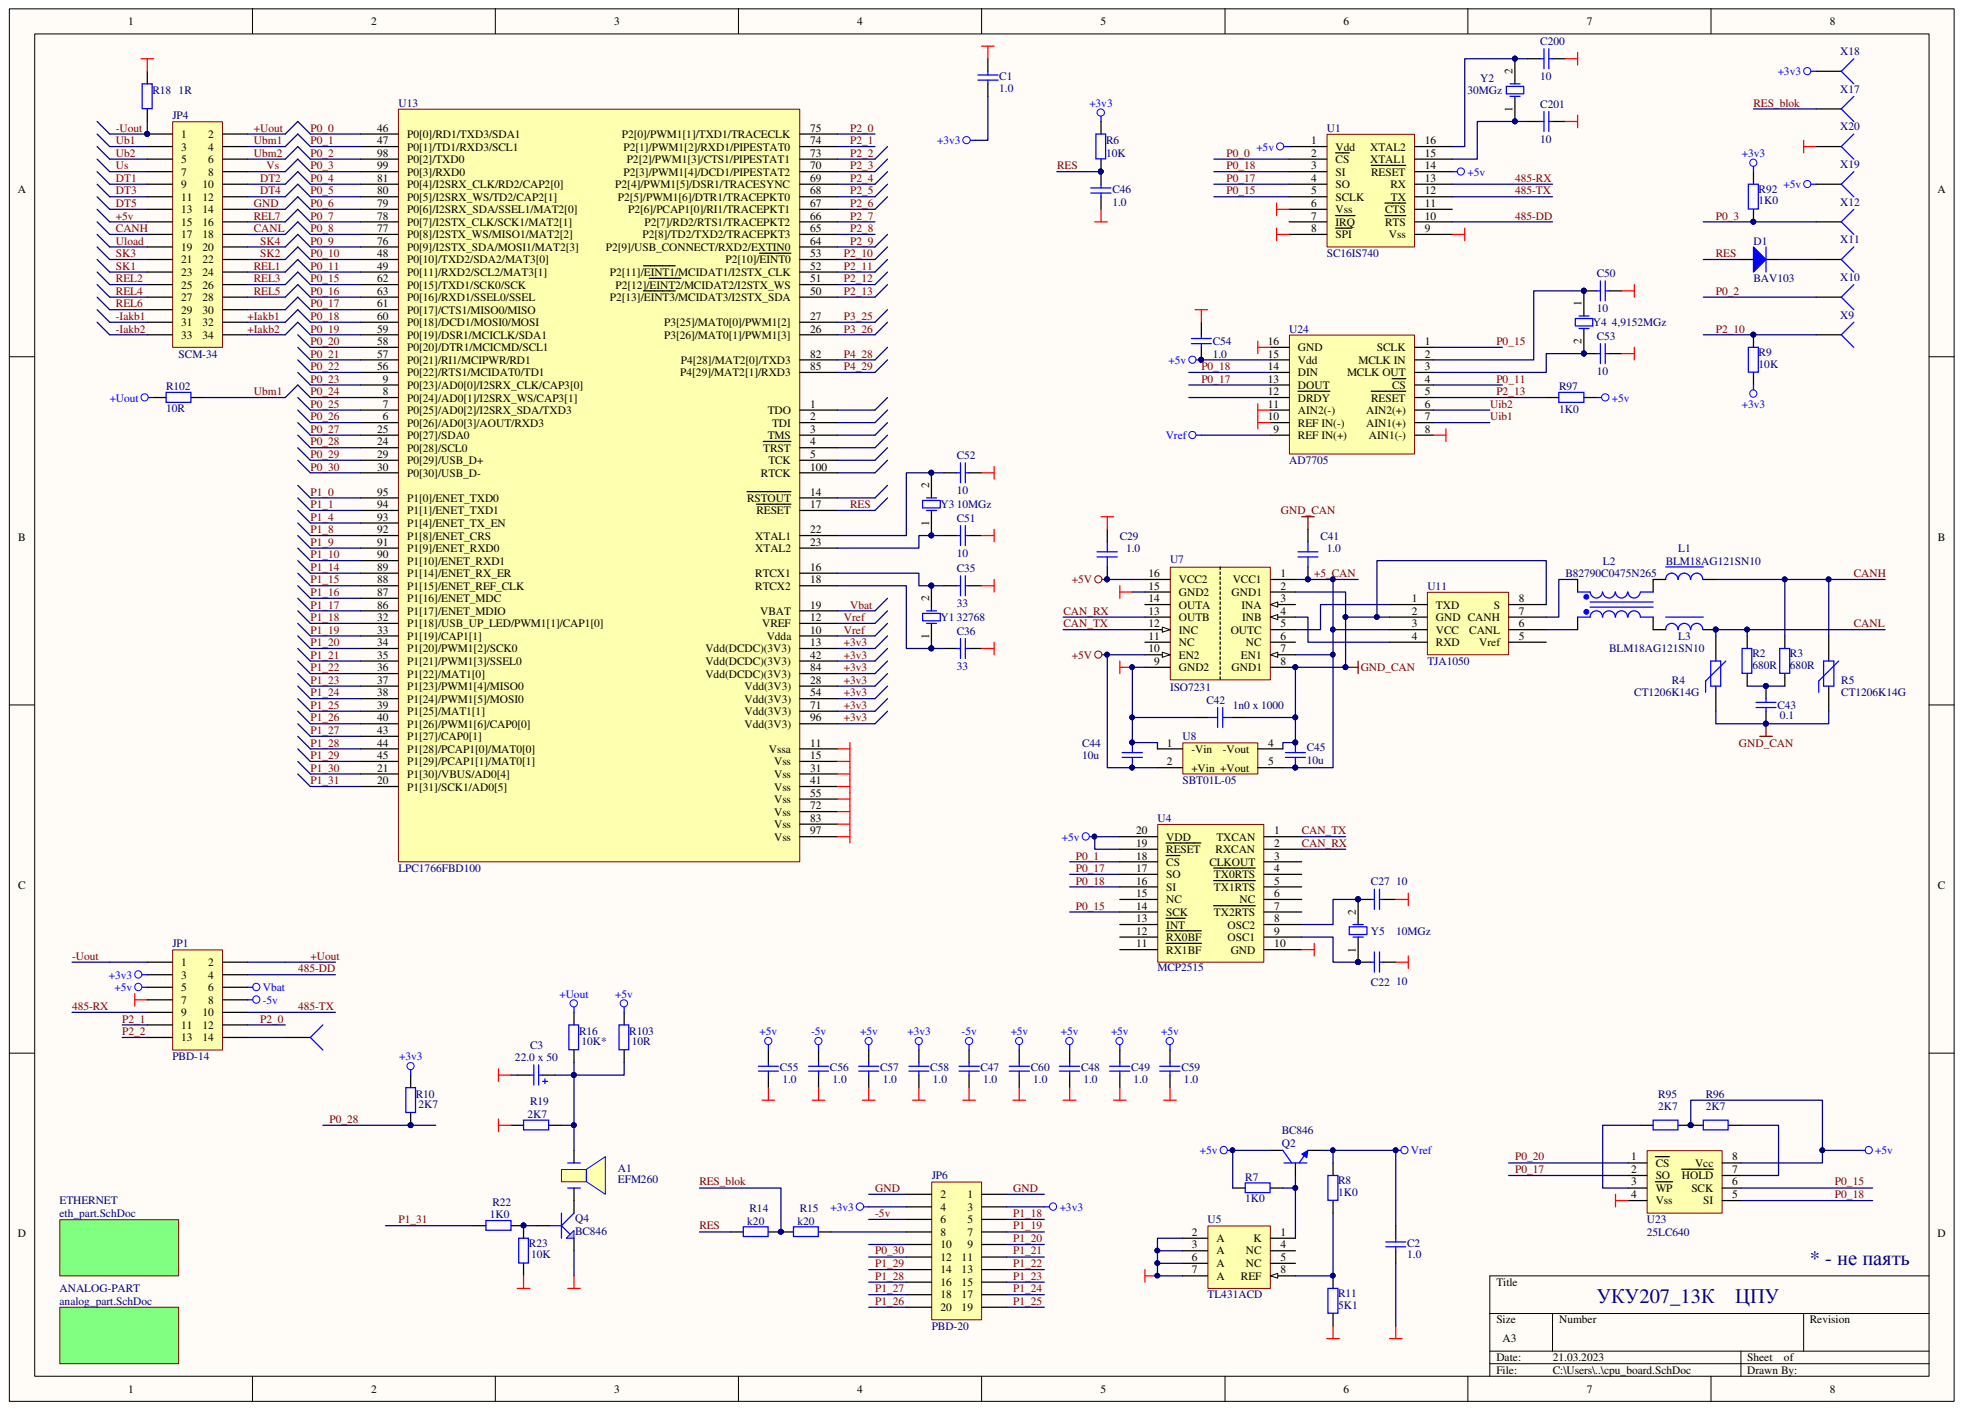
[picture p46: page 1]
