spa-pal/UKU207_DOCS/src/Монтаж ps518684 УКУ207_13И/Схемы плата/Плата УКУ207.13И.pdf

200R

# AG1232L3

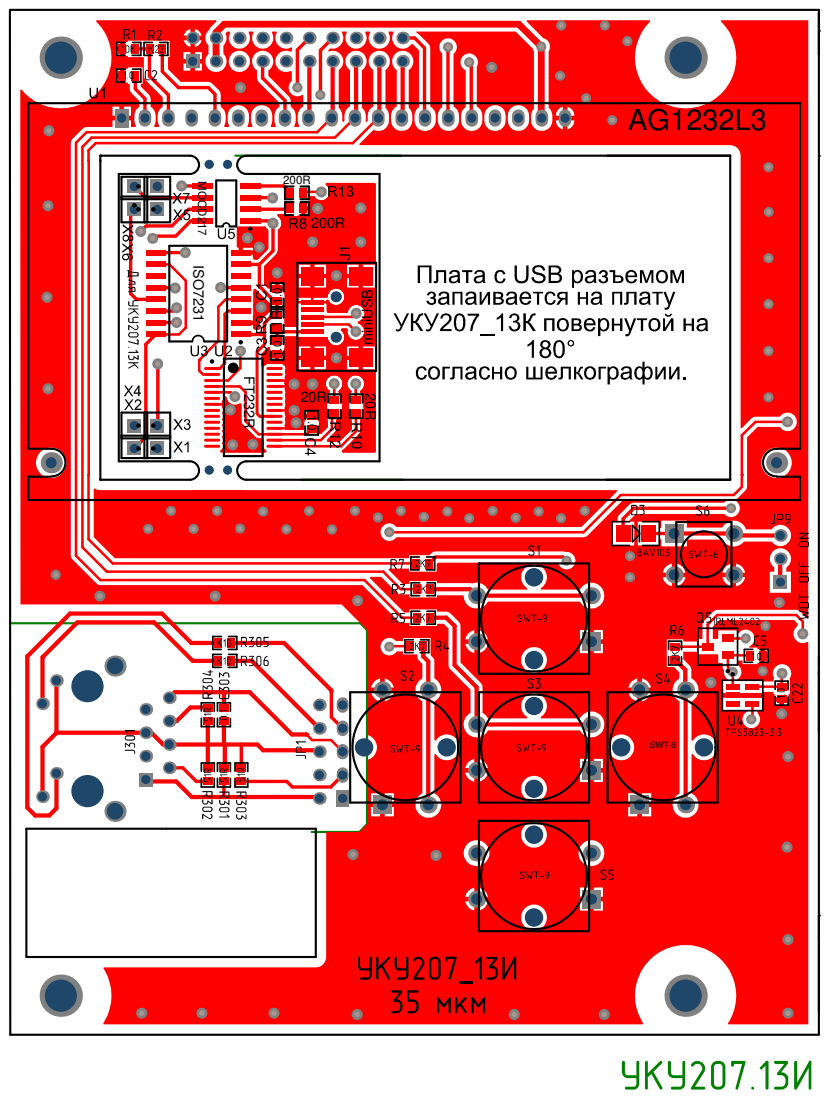
[picture p47: page 1]
20R miniUSB; ISO7231 MOCD217; SWT-9

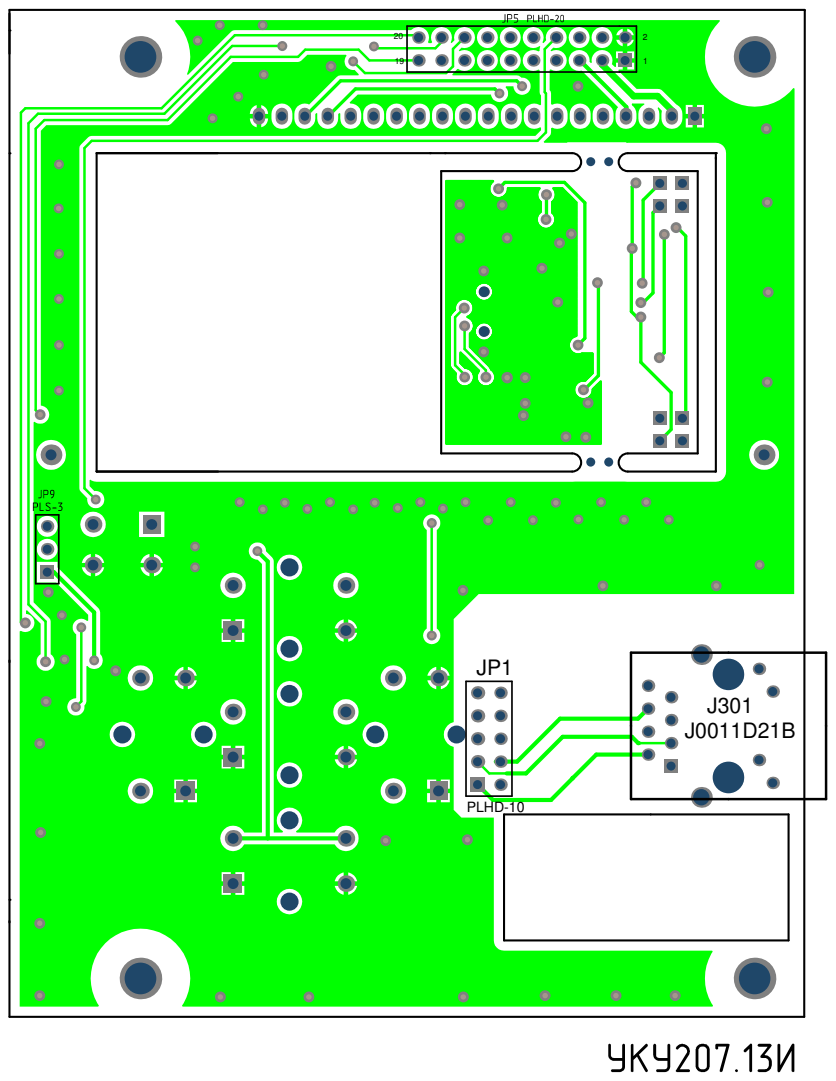
[picture p48: page 2]
PLHD-10
