spa-pal/UKU207_DOCS/src/Монтаж ps518684 УКУ207_13И/Схемы плата/Схема LAN.pdf

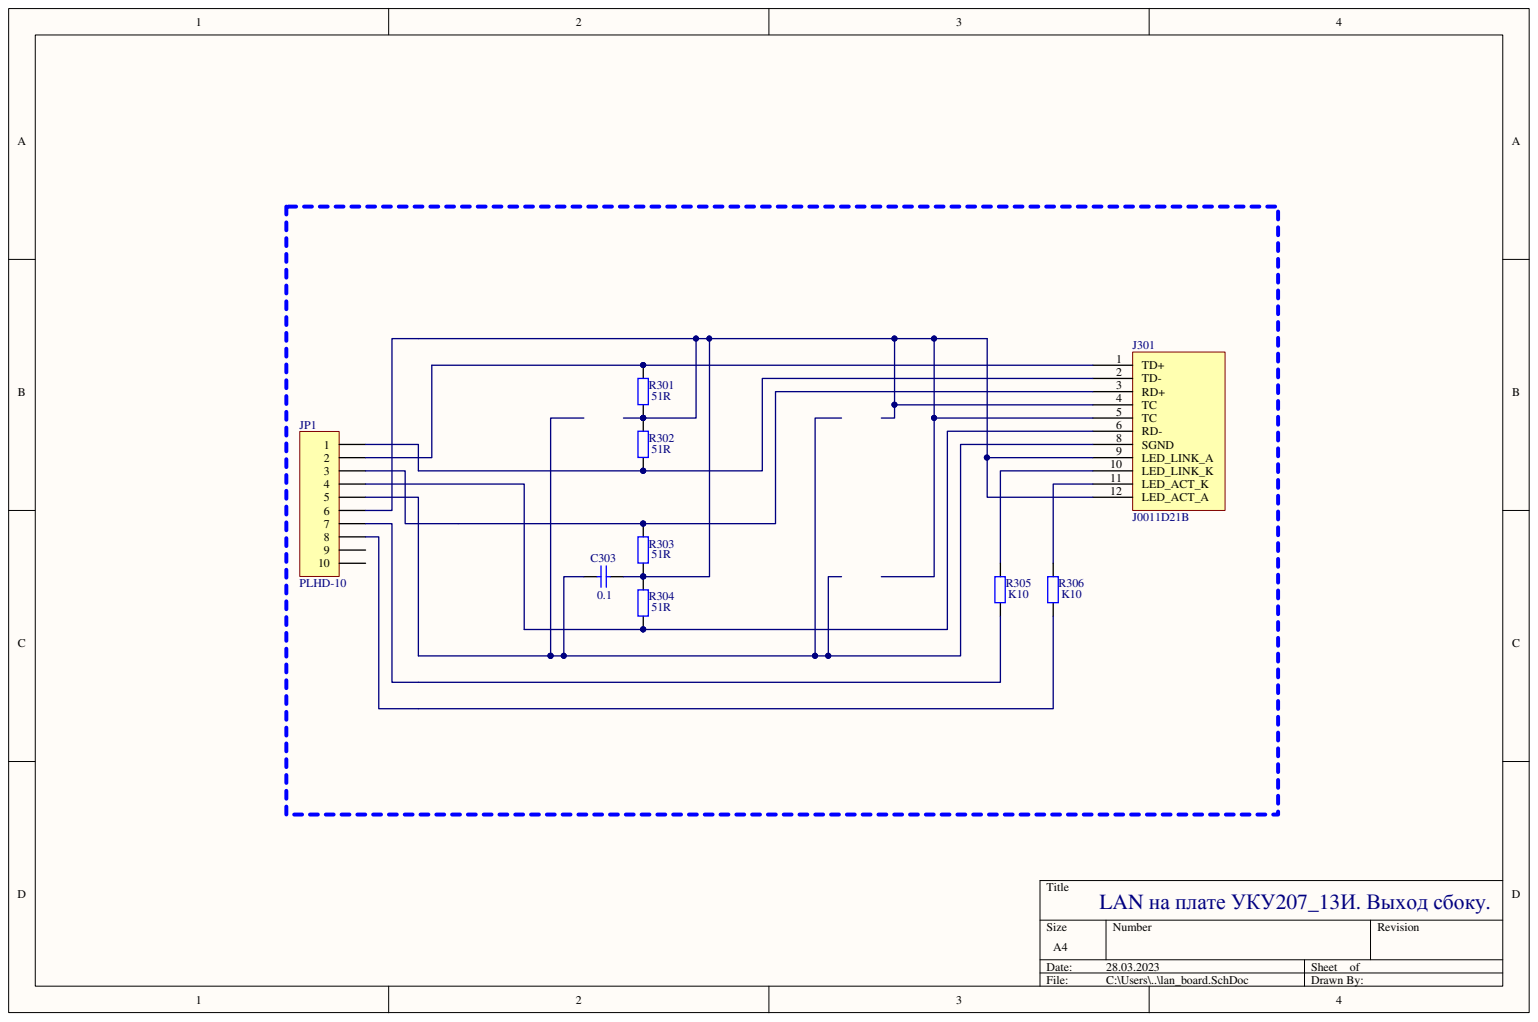
[picture p49: page 1]

Title
LAN на плате УКУ207_13И. Выход сбоку.
