spa-pal/UKU207_DOCS/src/Монтаж ps518684 УКУ207_13И/Схемы плата/Схема индикатор.pdf

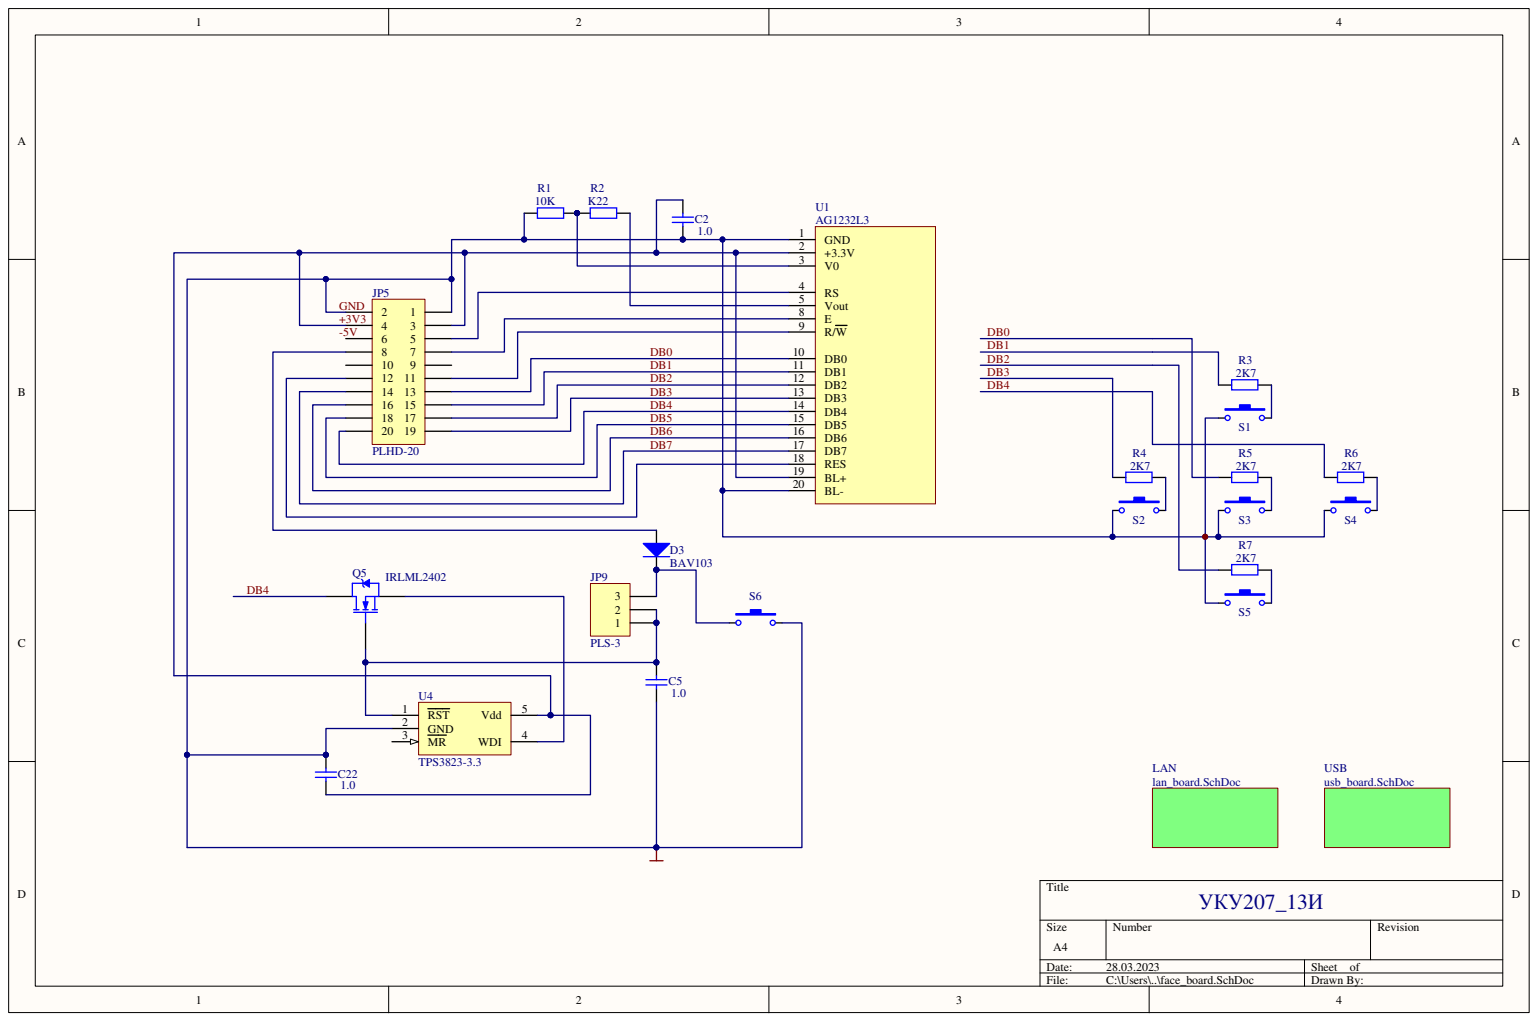
[picture p50: page 1]
