spa-pal/UKU207_DOCS/src/Монтаж ps518684 УКУ207_13И/Схемы плата/Схема программатора.pdf

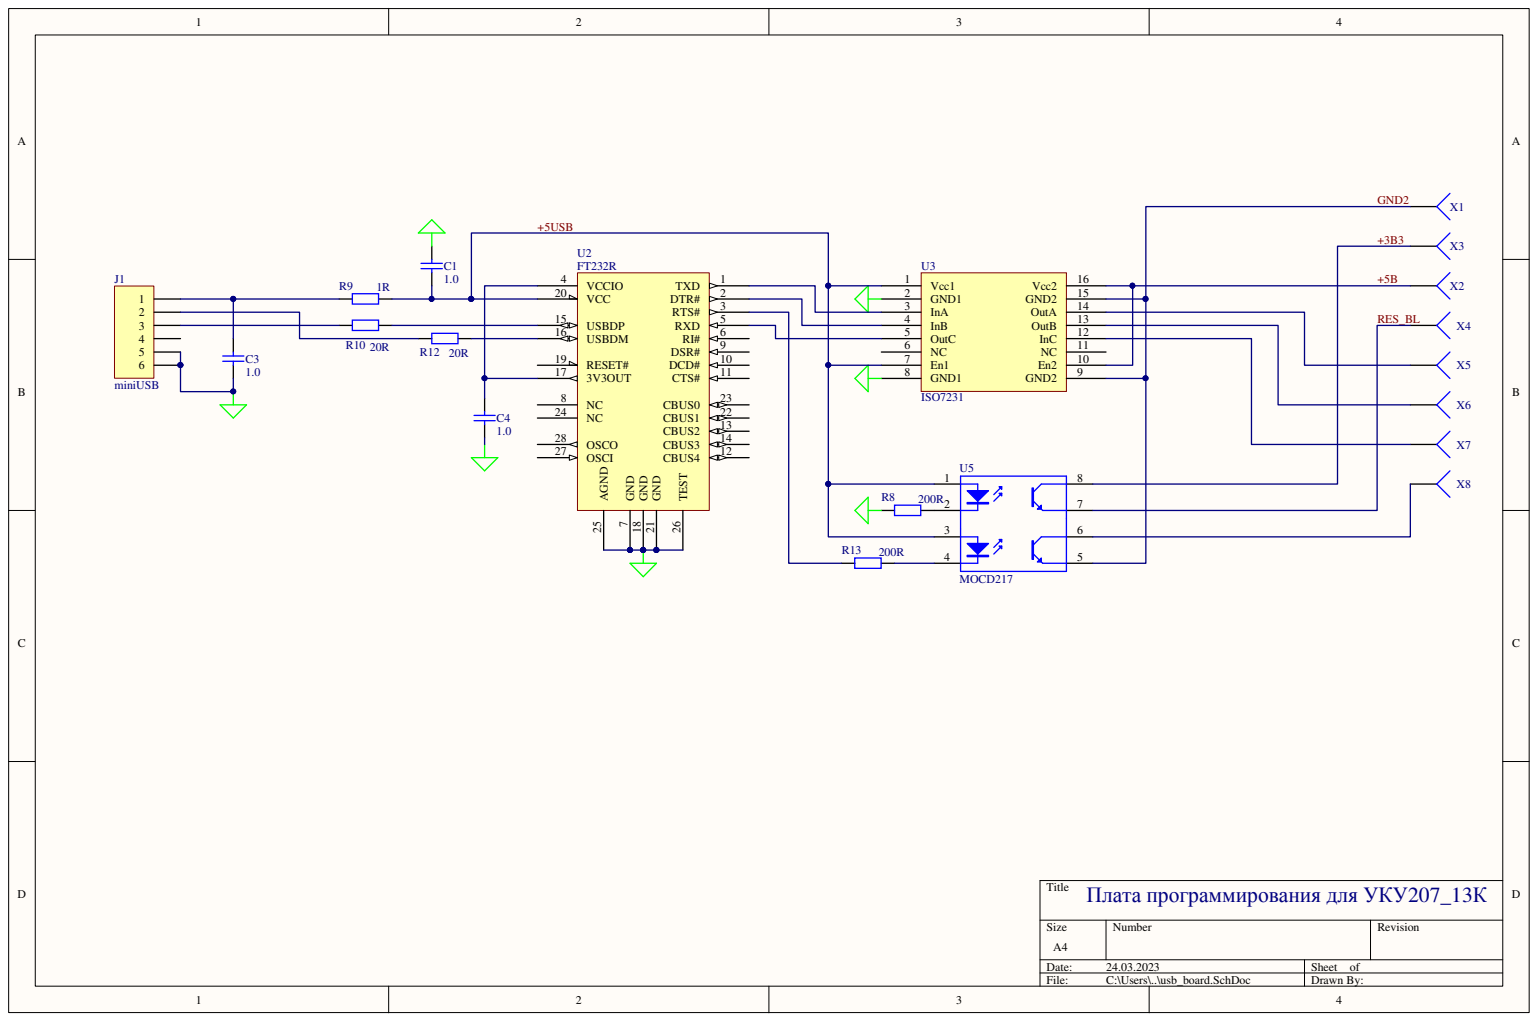
[picture p51: page 1]
