spa-pal/UKU207_DOCS/src/Монтаж ps518685 УКУ207_14И/Схемы плата/Плата УКУ207.14И.pdf

200R

# AG1232L3

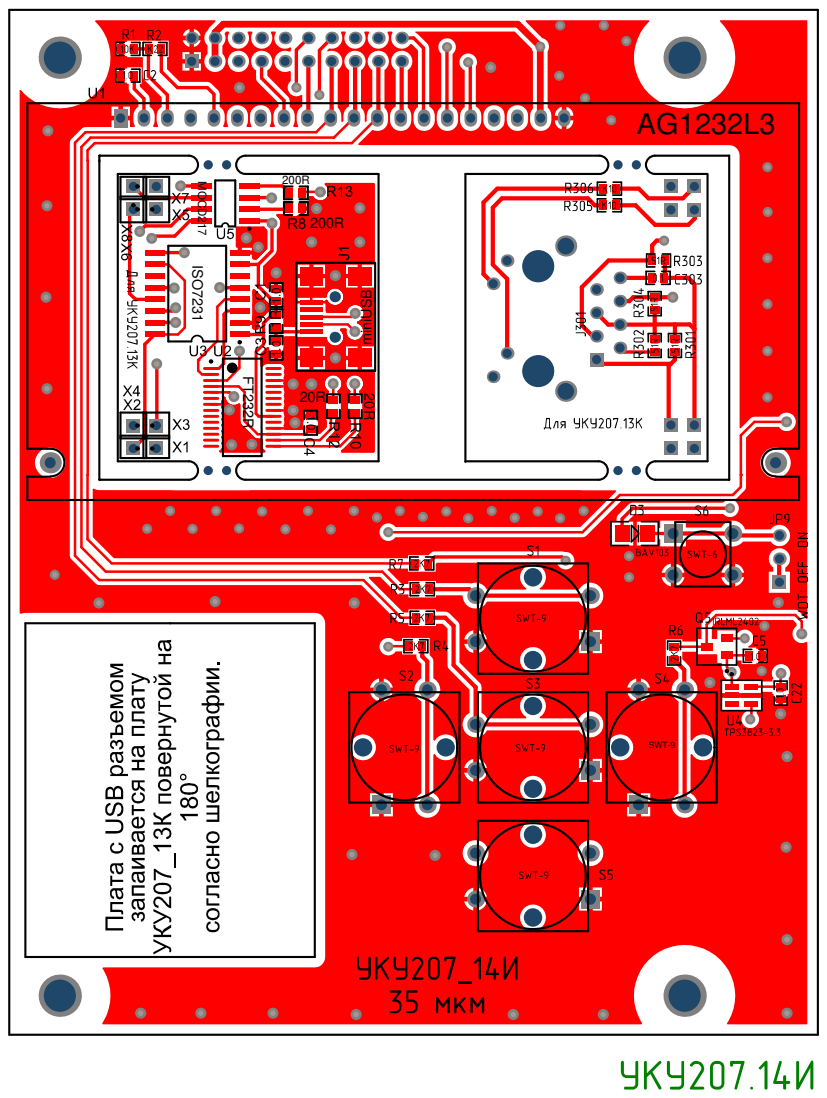
[picture p52: page 1]
20R miniUSB; MOCD217 ISO7231; SWT-9

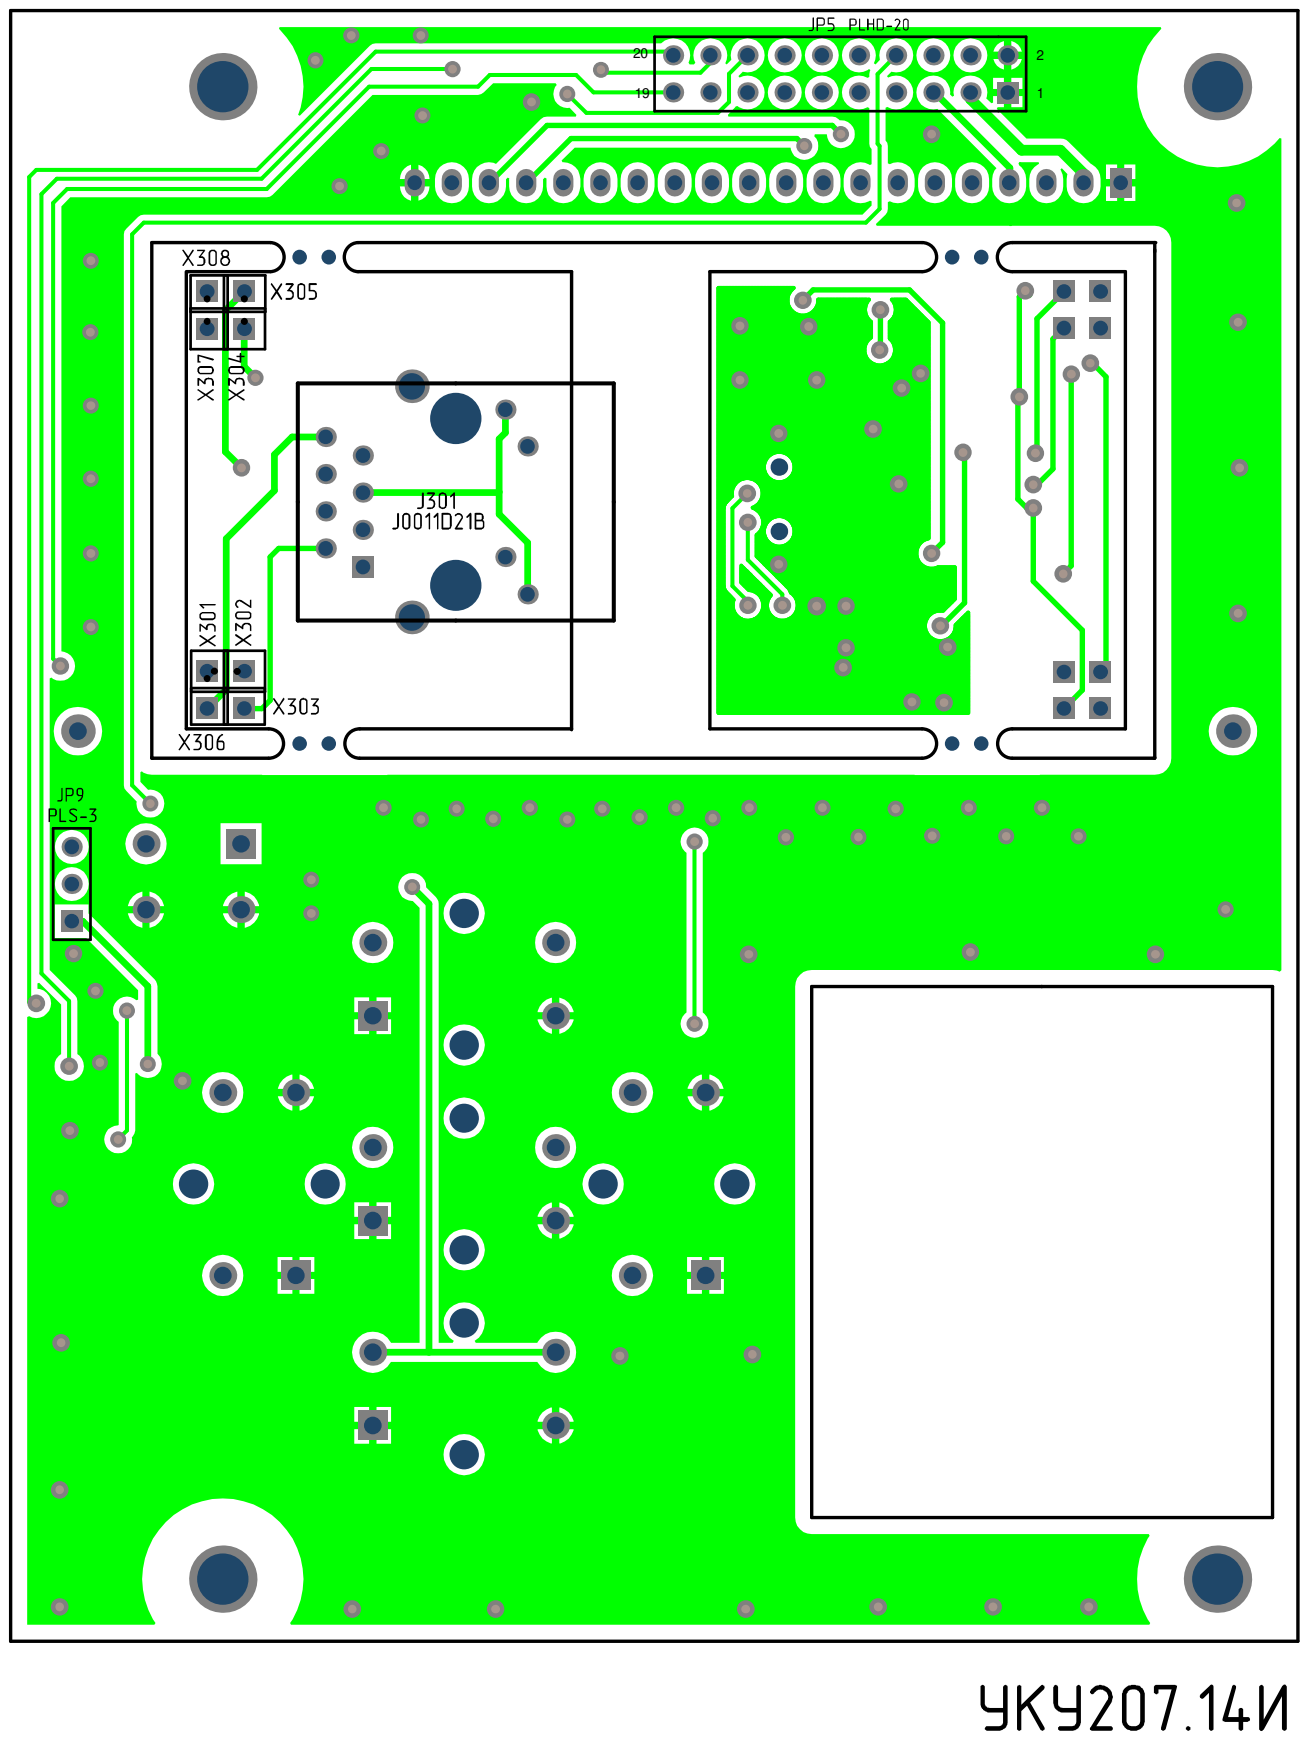
[picture p53: page 2]
