spa-pal/UKU207_DOCS/src/Монтаж ps518685 УКУ207_14И/Схемы плата/Схема LAN.pdf

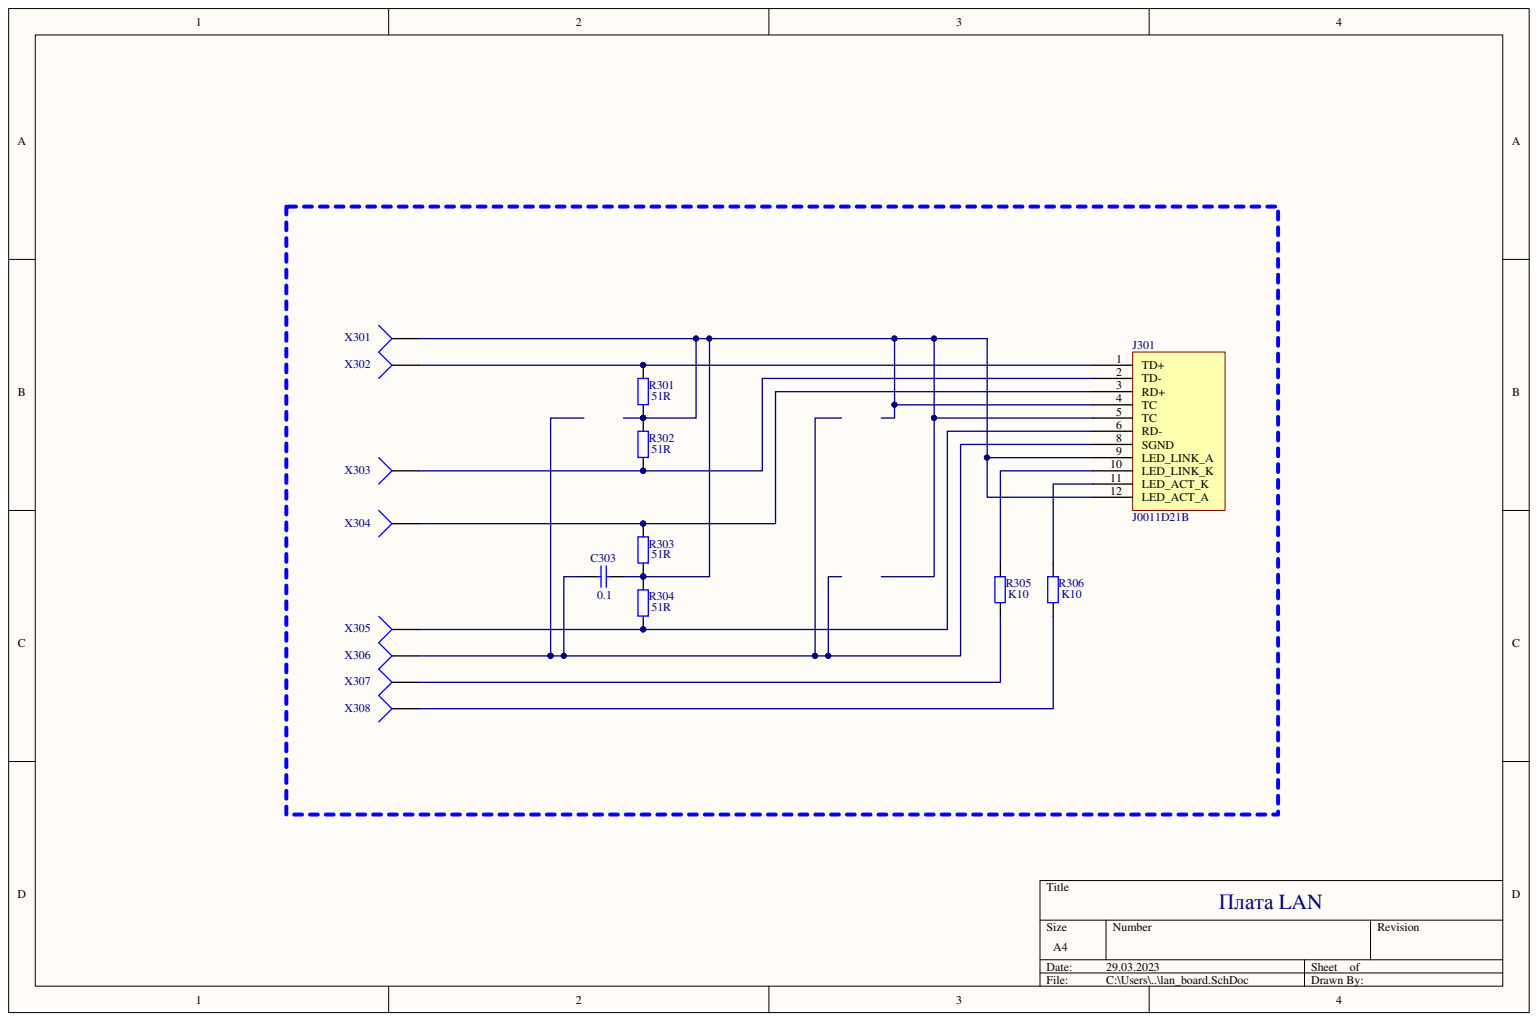
[picture p54: page 1]
