spa-pal/UKU207_DOCS/src/Монтаж УКУ207_16И/Схемы плата/Плата УКУ207.16И.pdf

# AG1232L3

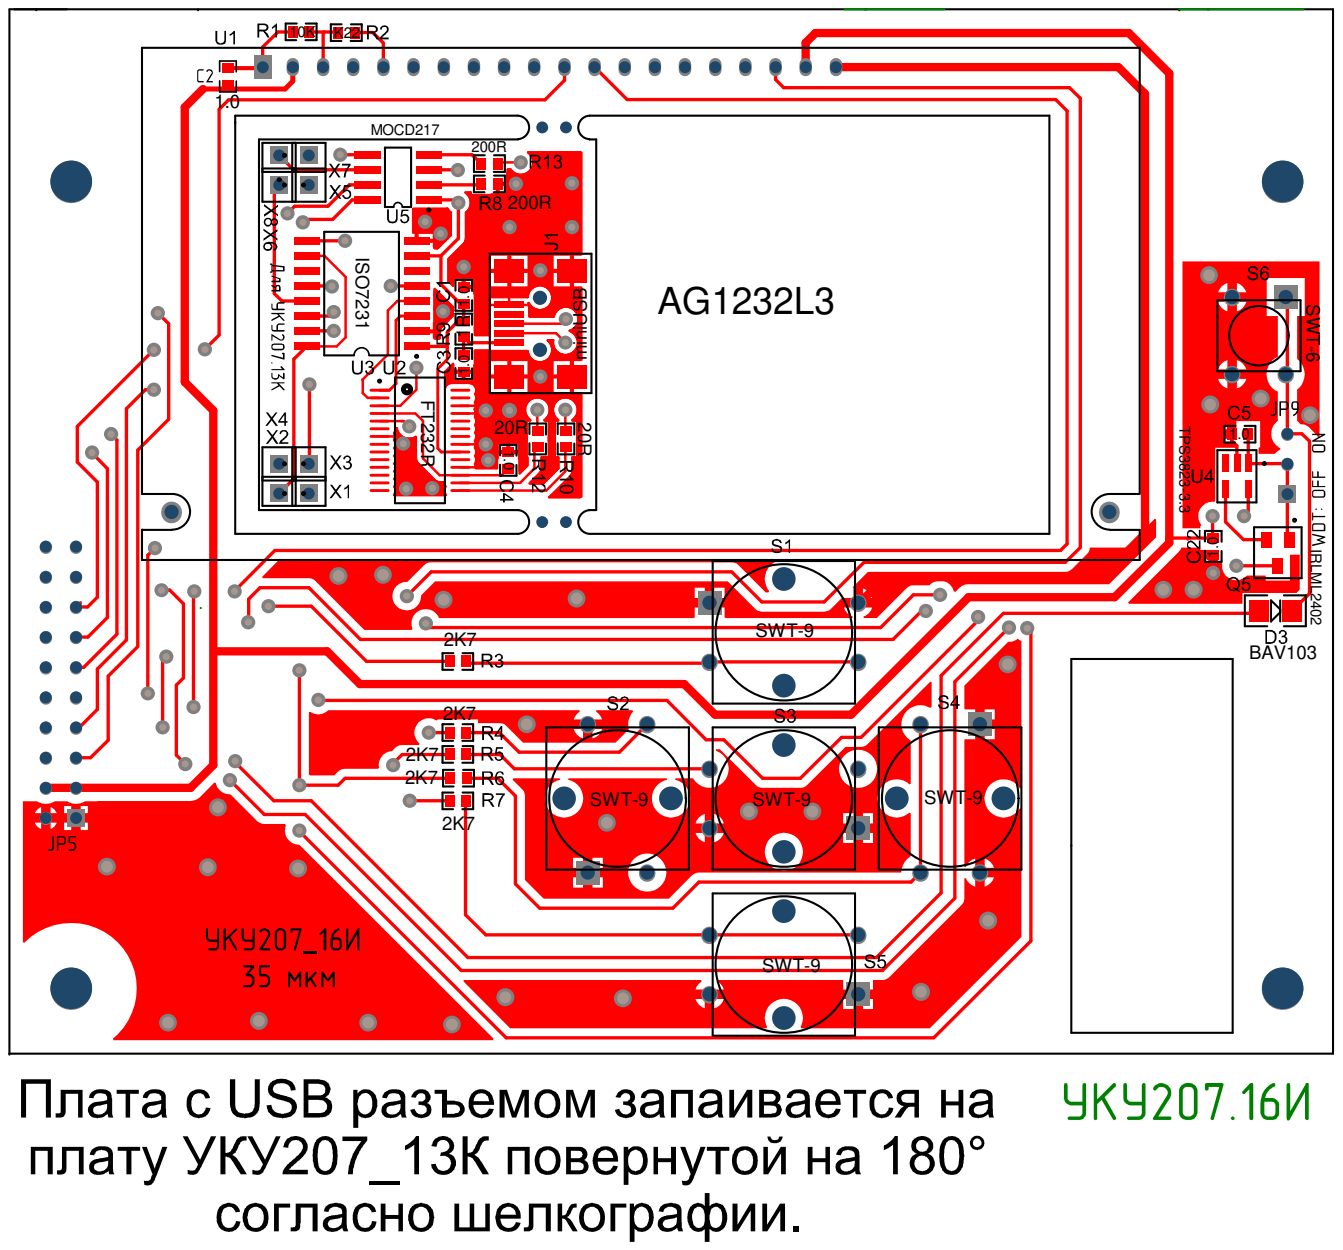
[picture p55: page 1]
miniUSB; ISO7231; TPS3823-3.3; SWT-9; BAV103; MOCD217; SWT-6; IRLML2402

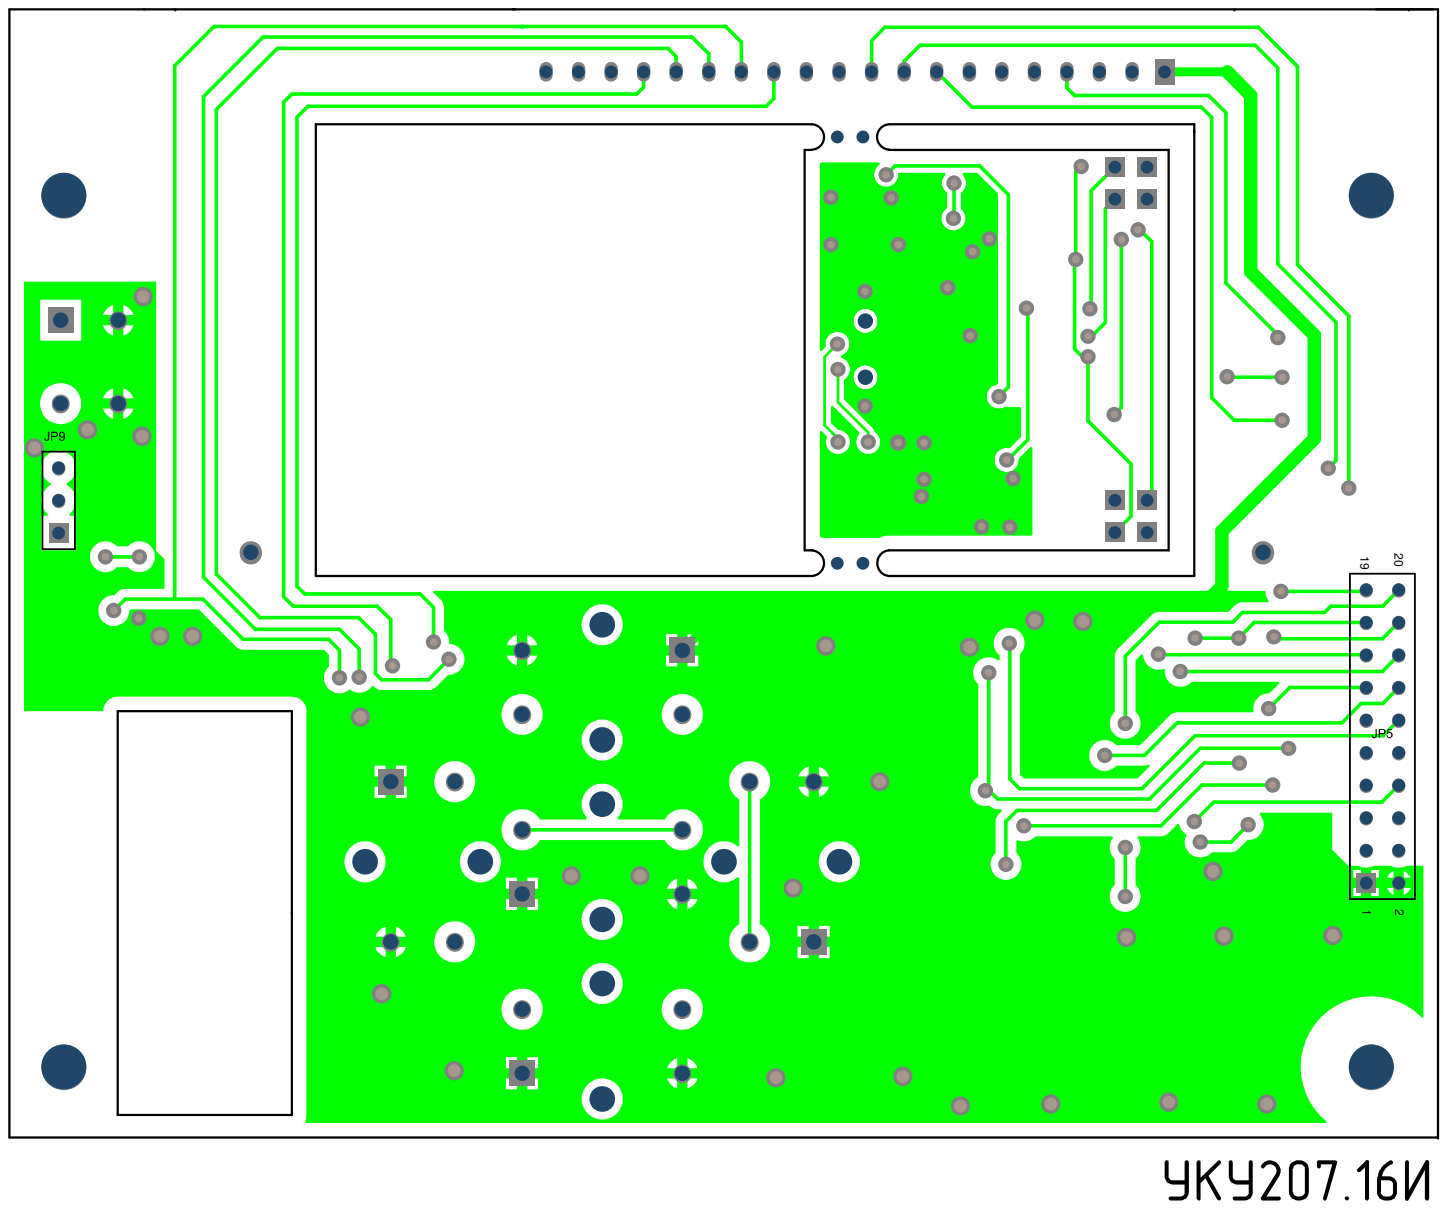
[picture p56: page 2]
