spa-pal/UKU207_DOCS/src/Монтаж УКУ207_16И/Схемы плата/Схема УКУ207.16И.pdf

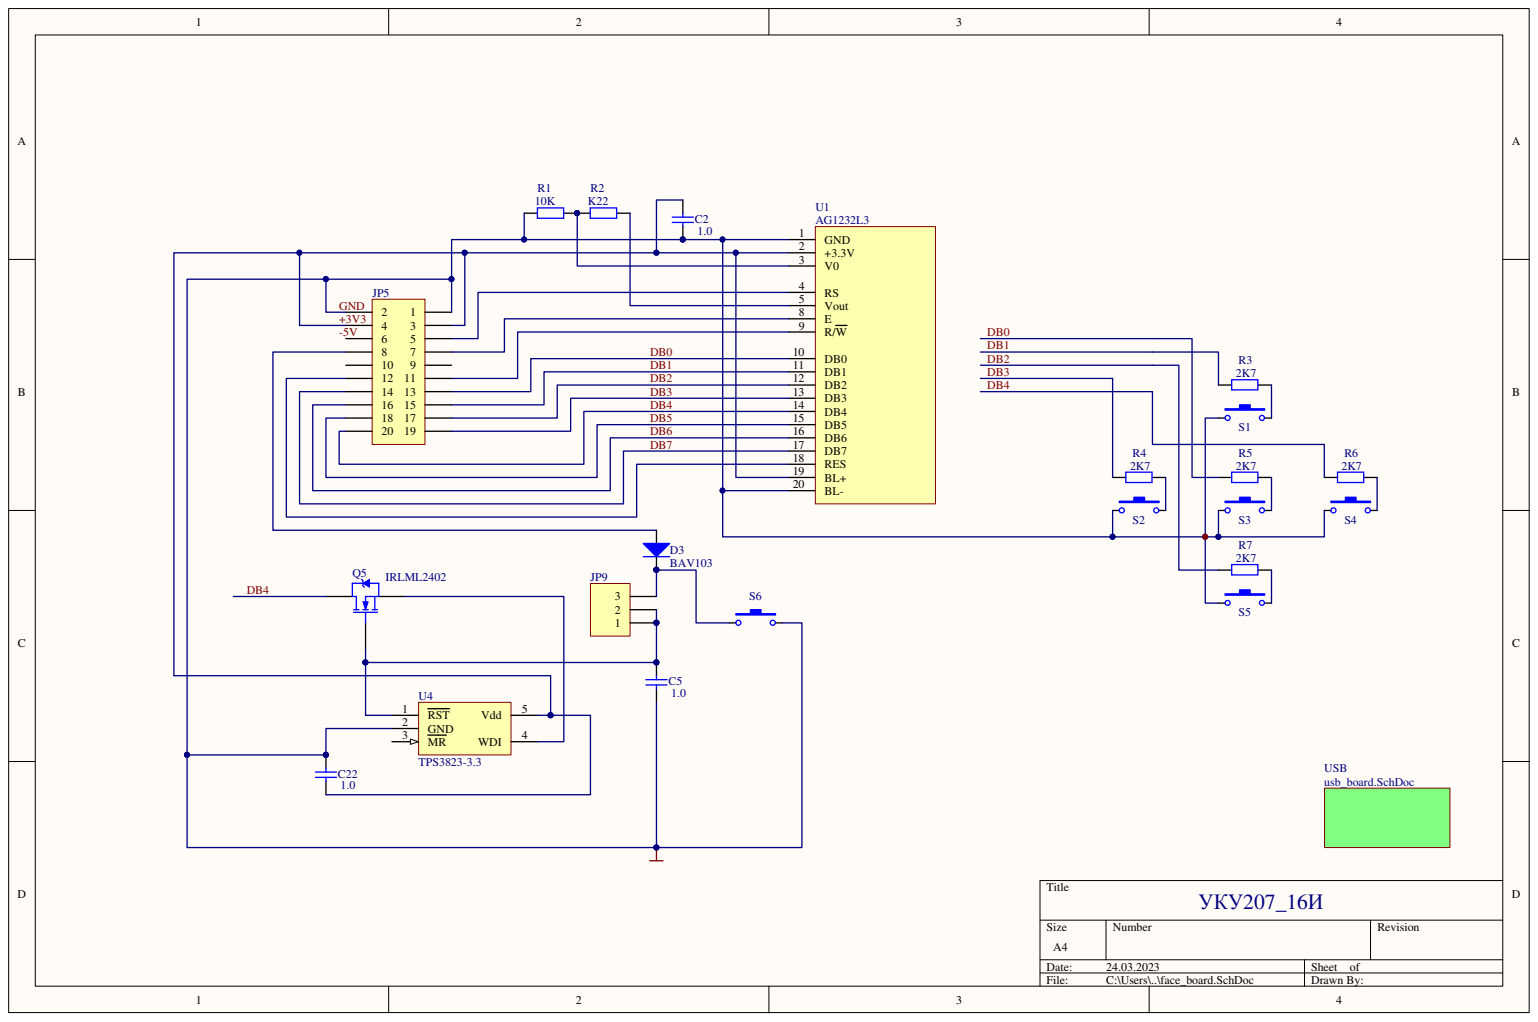
[picture p57: page 1]
