spa-pal/UKU207_DOCS/(list of files, drawings)

Other design files:
src/УКУ207_13К_v2(4).pcb
src/УКУ207_13К_v2.pcb
УКУ207.12.220/UKU207XX_POWER_BOARD.PCBDOC
УКУ207.14.48/uku207xx_power_board.PcbDoc
